sri-automation/strip-cutter/Cutter_v6_templates_1to1_A4.pdf

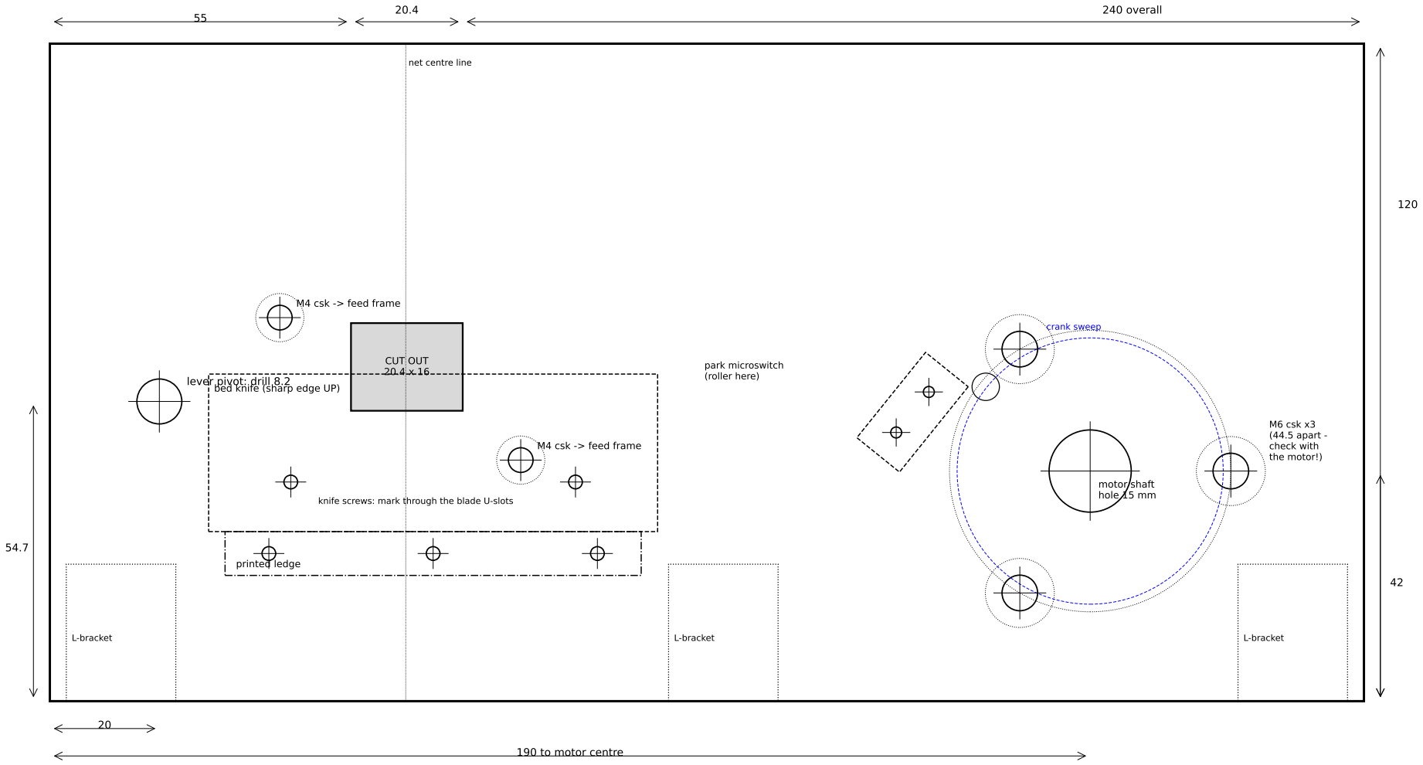
[picture p2: figure]
CUT; OUT; lever pivot: drill 8.2; M4 csk -> feed frame; bed knife (sharp edge UP); printed; ledge; L-bracket; net centre line; motor shaft hole 15 mm; M6 csk x3 (44.5 apart - check with the motor!); crank sweep; park microswitch (roller here); 190 to motor centre; 240 overall

knife screws: mark through the blade U-slots

MAIN PLATE (8 mm plywood, 240 x 120) - FRONT face (knife side). Stepper / motor side on the RIGHT.

<- must measure exactly 100 mm (print at 100 %, "actual size")

Tape on the plywood, cut the outline and the window, drill. Pivot 8.2 mm (M8). Motor shaft 15 mm (spade bit). M4 frame screws: 4.5 mm + countersink this face. MOTOR HOLES: drill the 15 mm shaft hole first. Put the motor behind the plate, shaft through the hole, body pointing UP and to the right (away from the stepper). Dab paint/marker on the 3 boss tops, press the motor on, the dots show the true hole centres. Drill 6.5 mm, countersink this face for M6 x 20 flat heads.
Knife / ledge / switch holes: drill 2.5 mm pilots when you fit those parts (mark through the real parts).

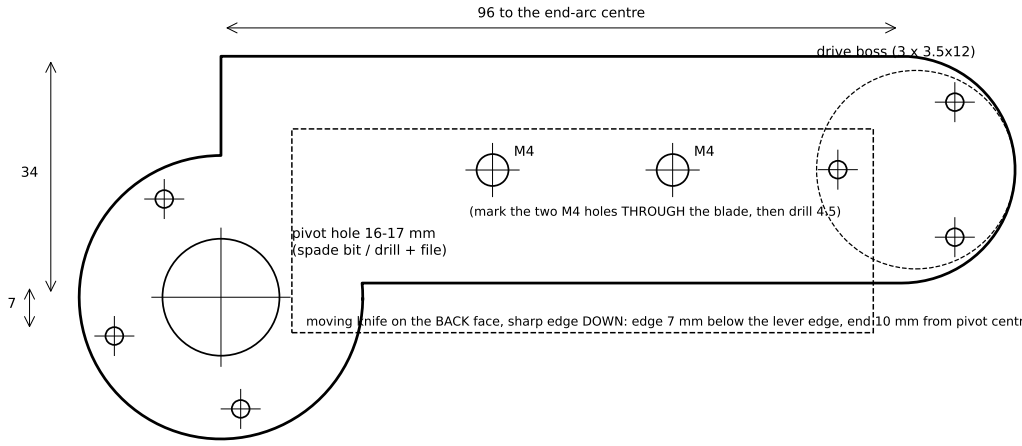
[picture p3: figure]
pivot hole 16-17 mm (spade bit / drill + file); drive boss (3 x 3.5x12); 96 to the end-arc centre

pilots 2.5 for the hub screws (3.5 x 12) moving knife on the BACK face, sharp edge DOWN: edge 7 mm below the lever edge, end 10 mm from pivot centre

(mark the two M4 holes THROUGH the blade, then drill 4.5)

LEVER (8 mm plywood) - FRONT face (hub side). Pivot on the LEFT.

Cut the outline (jigsaw / coping saw), bore the 16-17 mm pivot hole, drill the 2.5 mm pilots.
Drive-boss pilots: max 6 mm deep - the moving knife sits behind one of them.
The knife goes on the BACK face (the face toward the main plate), bevel against the plywood, flat face outward.
Clamp the blade 7.0 mm below and parallel to the lever's straight bottom edge, its end 10 mm right of the pivot centre, mark the 2 threaded holes through the blade, drill 4.5, fix with M4x12 + 2 washers from the front (tip must NOT stick out of the blade's flat face - add a washer if it does).
Drive pin: M8 x 45 hex bolt, head in the printed drive boss (hex pocket against the lever), thread pointing out.

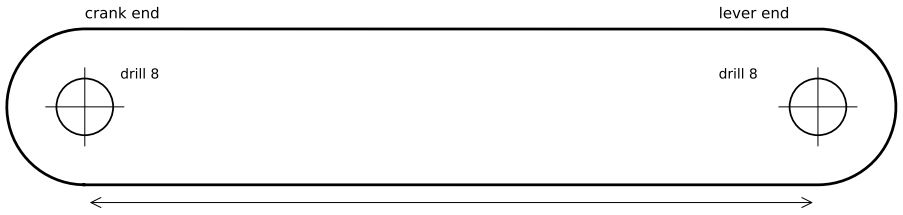
[picture p4: figure]
drill 8; crank end; lever end

103.4 hole centre to hole centre

# LINK (8 mm plywood) - 1:1

Drill the two 8 mm holes square to the face (drill press or a guide block). Check the centre distance: 103-104 mm is fine. Round the ends, sand the edges. A smear of grease in both holes.

STACK ON EACH M8 PIN (lever pin and crank pin are the same):
printed boss | M8 washer | LINK | M8 washer | M8 nylock (snug, then back 1/6 turn so the link turns freely)

The link must clear the M4 screw + washer on the end of the motor shaft by 1-2 mm.
If it rubs: add one more M8 washer under the link on BOTH pins (keeps the link square).
If there is a big gap (> 4 mm) that's fine - nothing to change.

CRANK ON THE MOTOR SHAFT:
1. Push the M8 x 45 crank-pin bolt through the crank from the flat (back) side; its head sits in the hex pocket.
2. Slide the M4 nut sideways into the slot next to the small radial hole; screw in the M4 x 10 grub screw a few turns.
3. Slide the crank on the shaft, flat side toward the plate, until its hub face is flush with the shaft end.
4. Turn the crank until the grub screw drops into the slot on the shaft; tighten it. Check there is ~1.5 mm gap to the plate.
5. M4 x 6 screw + 12 mm washer into the shaft end (keeps the crank from walking off). Only snug; the thread is 5 mm deep.

# BASE BOARD LAYOUT (8 mm plywood 285 x 275) - seen from ABOVE, scale 1:2 (NOT full size)

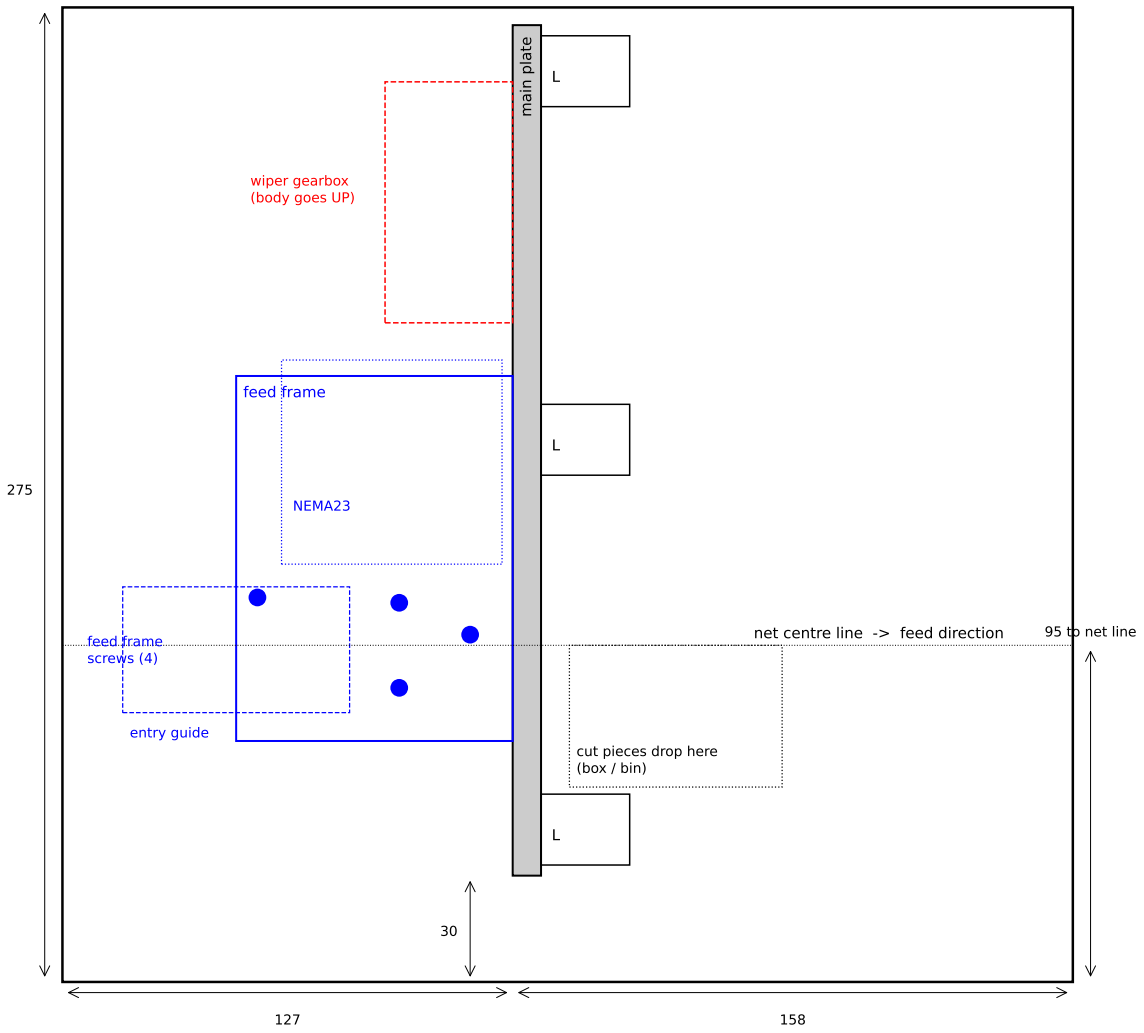
[picture p5: figure]
main plate; feed; frame; entry guide; NEMA23; wiper gearbox (body goes UP); screws (4); net centre line -> feed direction; cut pieces drop here (box / bin); 95 to net line

<- 100 mm bar is for printer check only; this page is NOT full size

Coordinates: the main plate's BACK face is 127 mm from the entry-side edge of the board; its left end is 30 mm from the board edge.
1. Stand the main plate on the board, back face on the line. 3 L-brackets on the FRONT (knife) side: wood screws into plate and board.
2. Push the feed frame against the plate's back face, net channel lined up with the window. 2 x M4 x 20 flat heads from the front
of the plate into the frame (holes on the template), then 4 wood screws (4 x 10-12 mm) through the frame's counterbored holes.
3. The motor bolts only to the plate - keep the gearbox >= 5 mm away from the stepper.
4. Cut pieces fall in front of the knife: put a small box there.
