sri-automation/strip-cutter/electronics_v5_app_phone.png

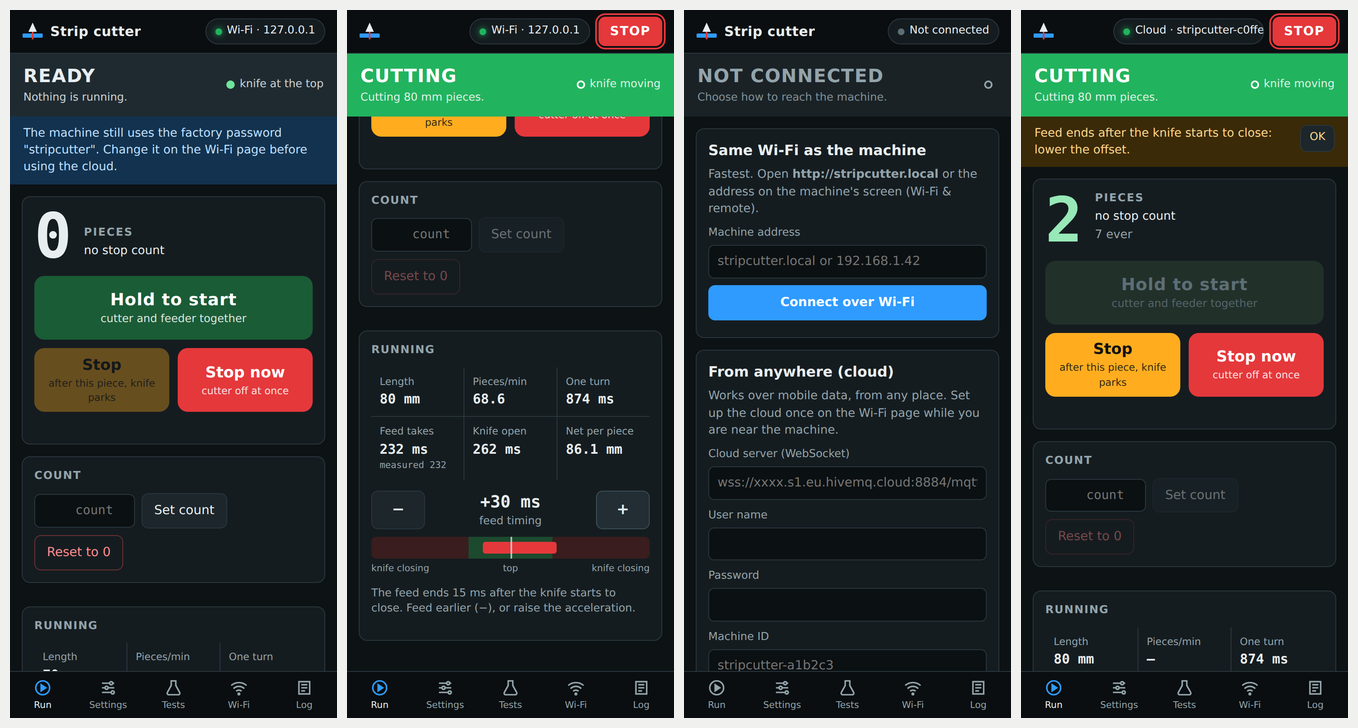
electronics_v5_app_phone.png
