sri-automation/strip-cutter/electronics_v5_screen_1.png

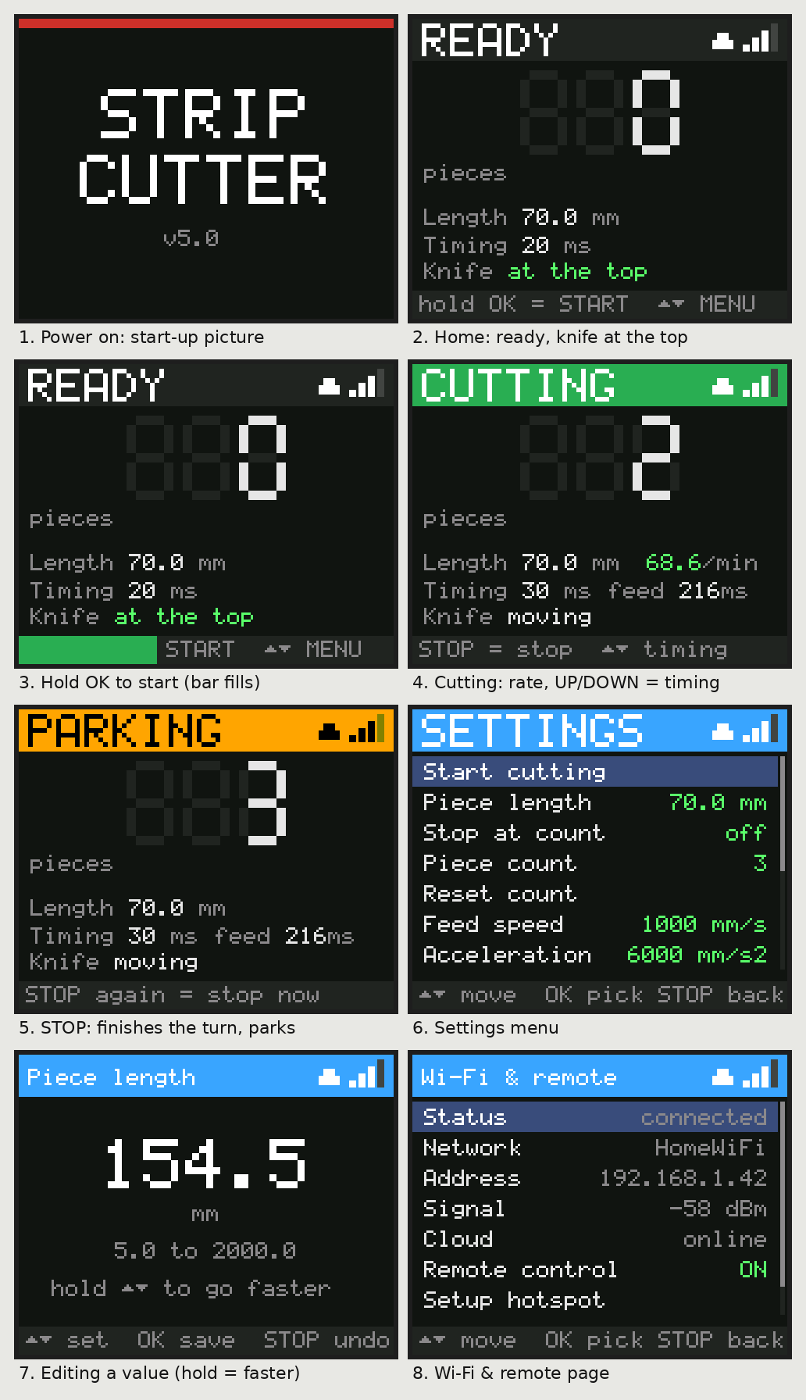
electronics_v5_screen_1.png
