sri-automation/strip-cutter/electronics_v5_screen_2.png

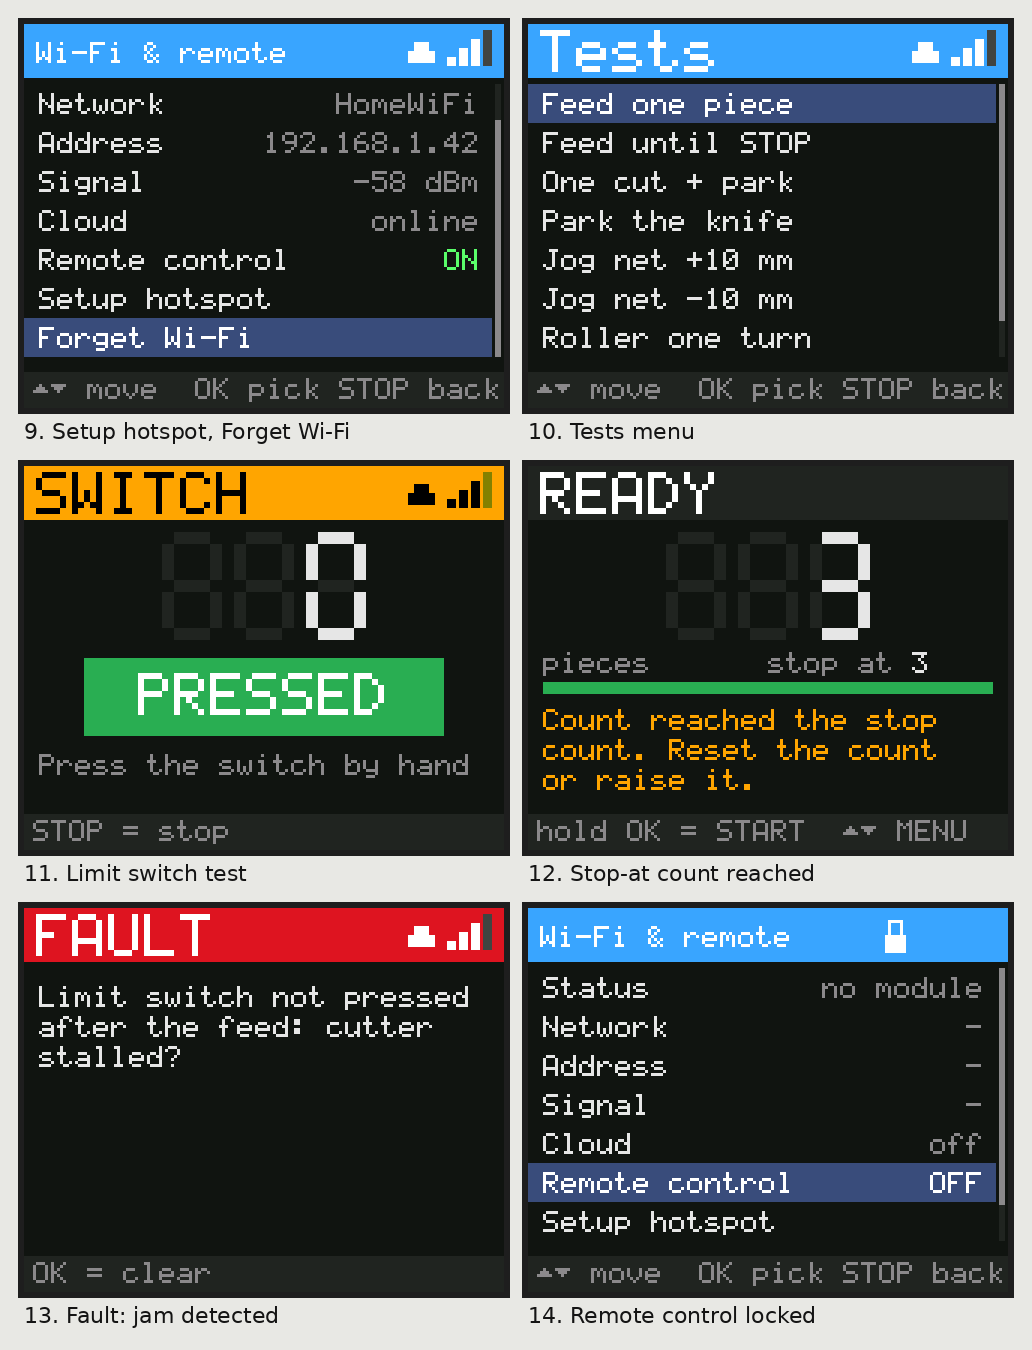
electronics_v5_screen_2.png
