sri-automation/strip-cutter/v4_view_entry_side.png

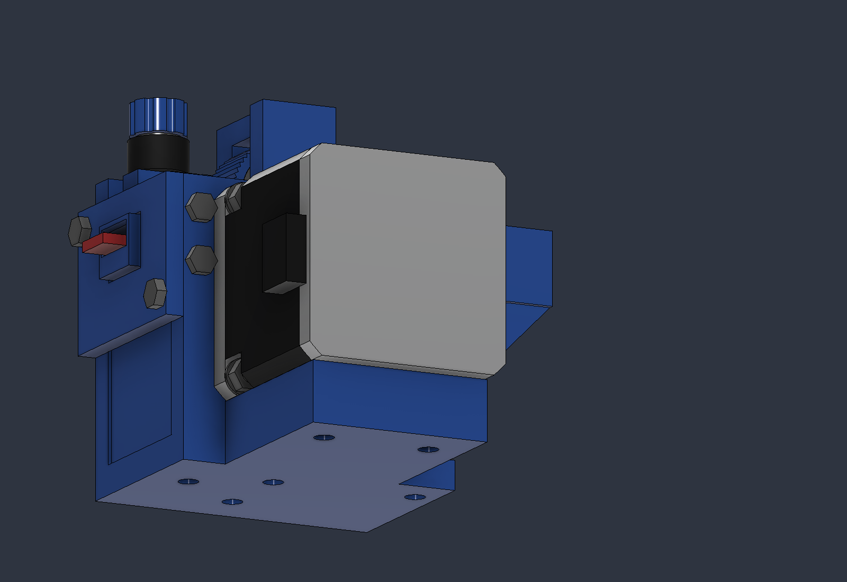
v4_view_entry_side.png
