sri-automation/strip-cutter/v5_nip_cheeks_explained.png

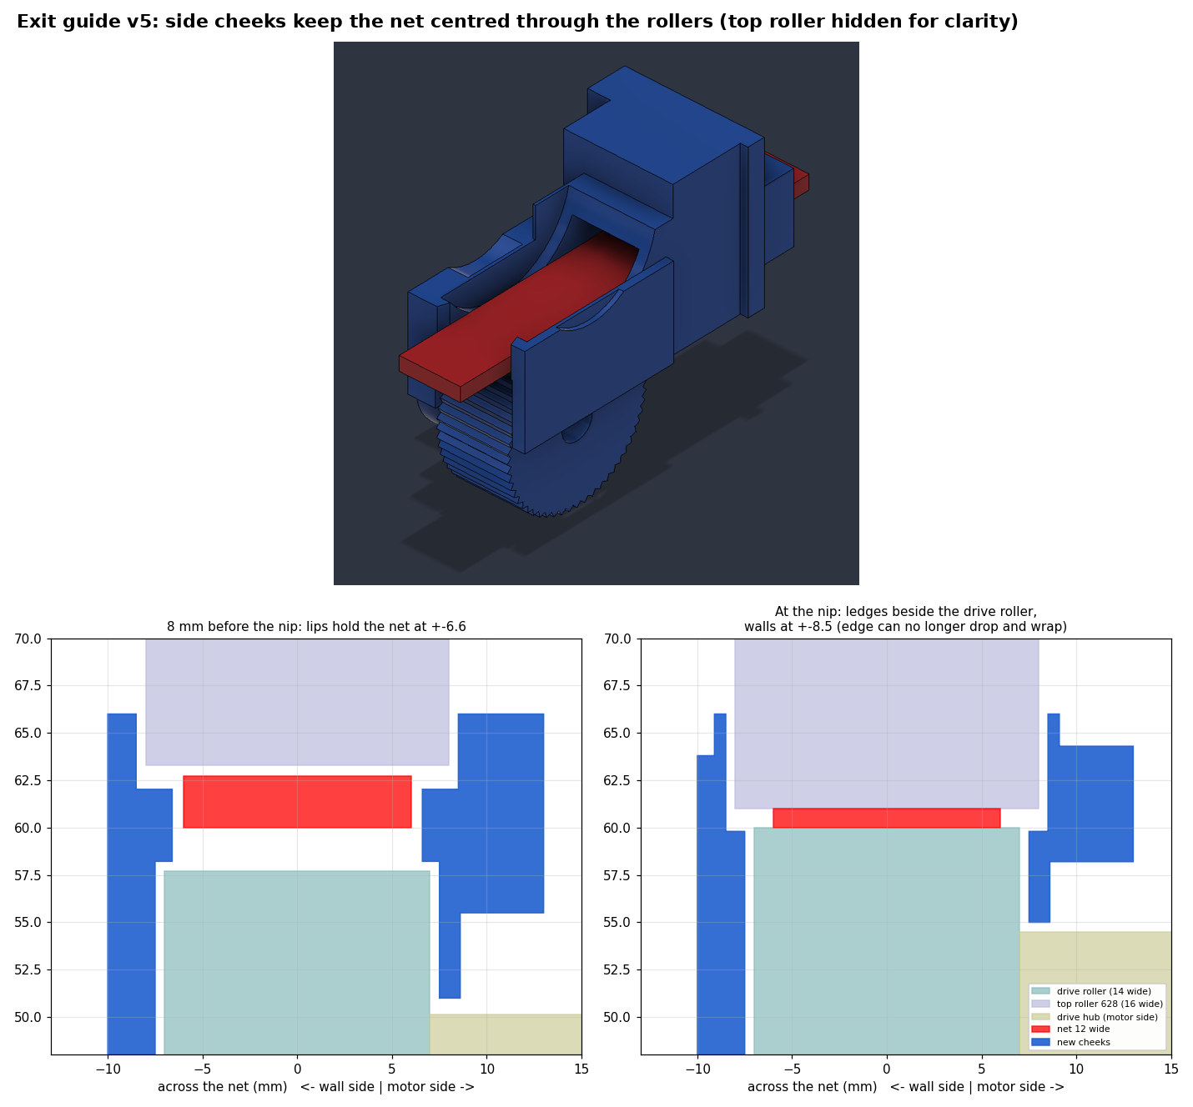
v5_nip_cheeks_explained.png
