sri-automation/strip-cutter/v5_nip_cheeks_top.png

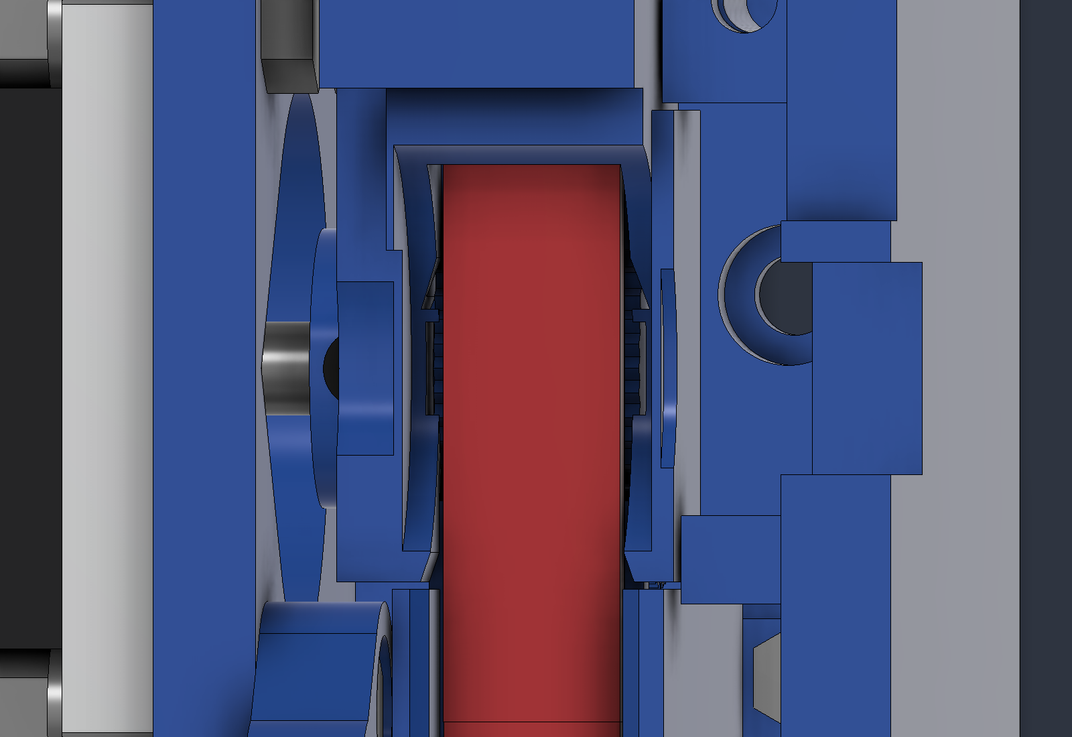
v5_nip_cheeks_top.png
