sri-automation/strip-cutter/v5_nip_cheeks_view.png

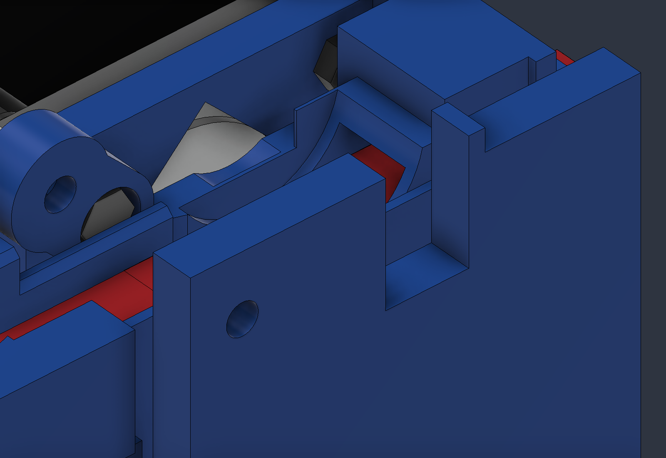
v5_nip_cheeks_view.png
