sri-automation/strip-cutter/v6_cutter_drive_back.png

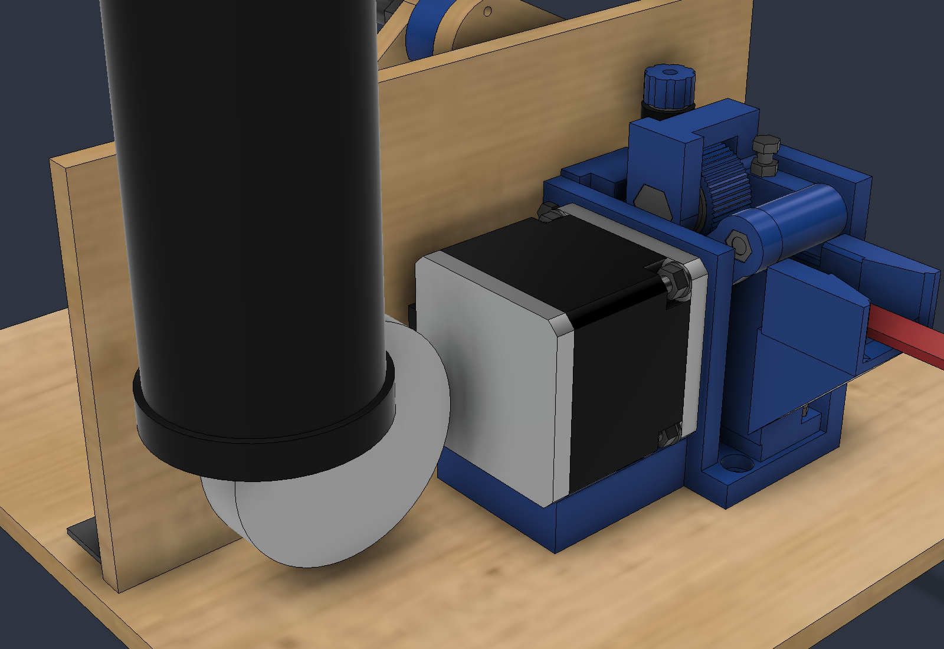
v6_cutter_drive_back.png
