sri-automation/strip-cutter/v6_cutter_drive_front.png

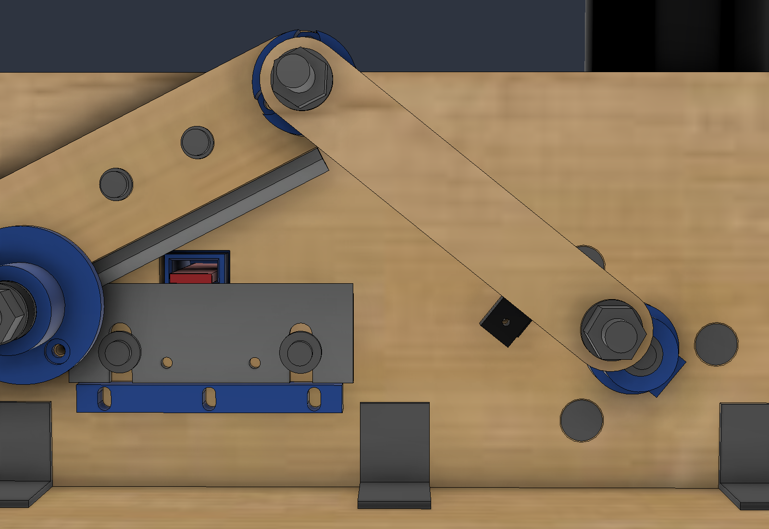
v6_cutter_drive_front.png
