sri-automation/strip-cutter/v6_cutter_drive_iso.png

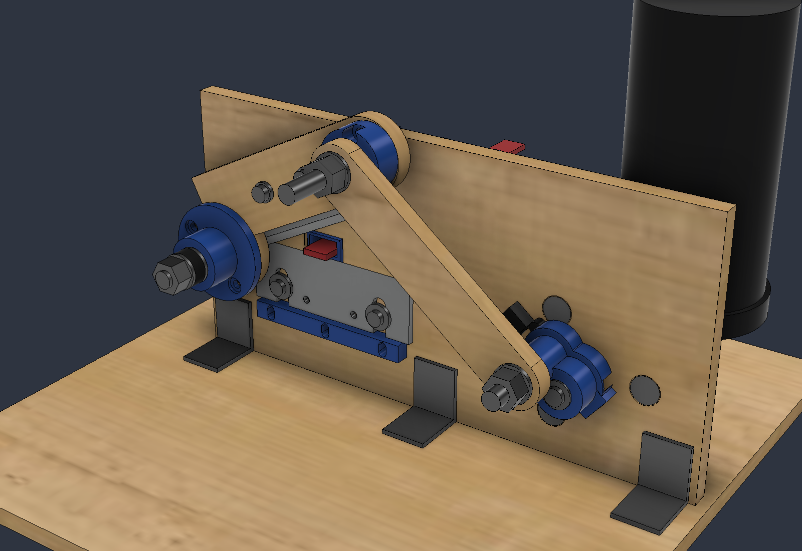
v6_cutter_drive_iso.png
