sri-automation/strip-cutter/v7_pinch_yoke.png

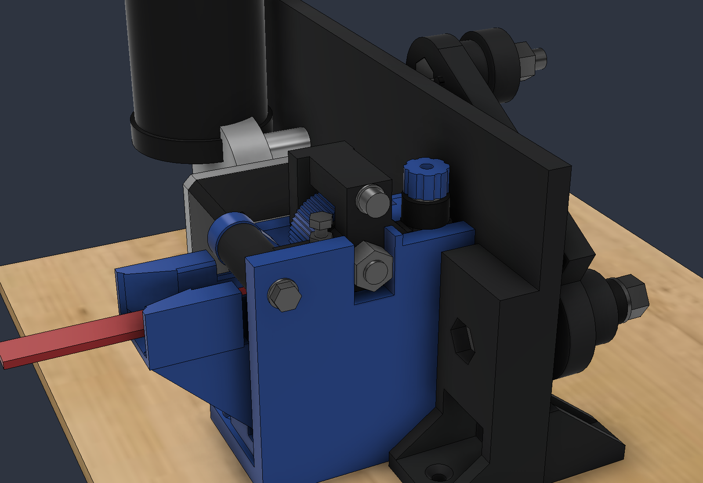
v7_pinch_yoke.png
