sri-automation/strip-cutter/v9_ramp_front.png

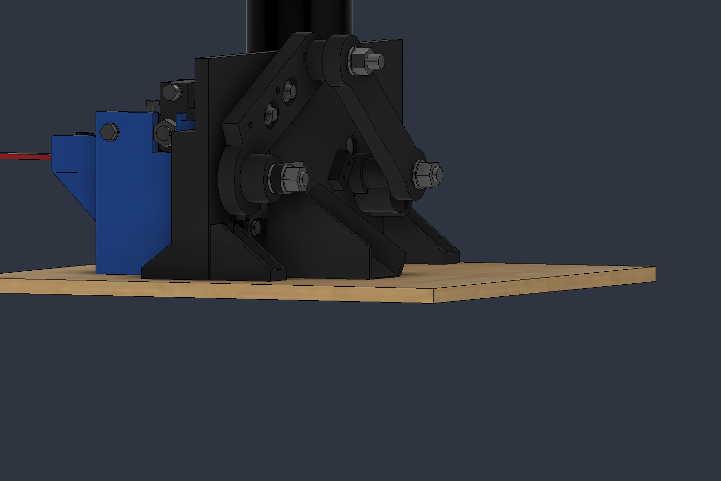
v9_ramp_front.png
