sri-automation/strip-cutter/v9_ramp_side.png

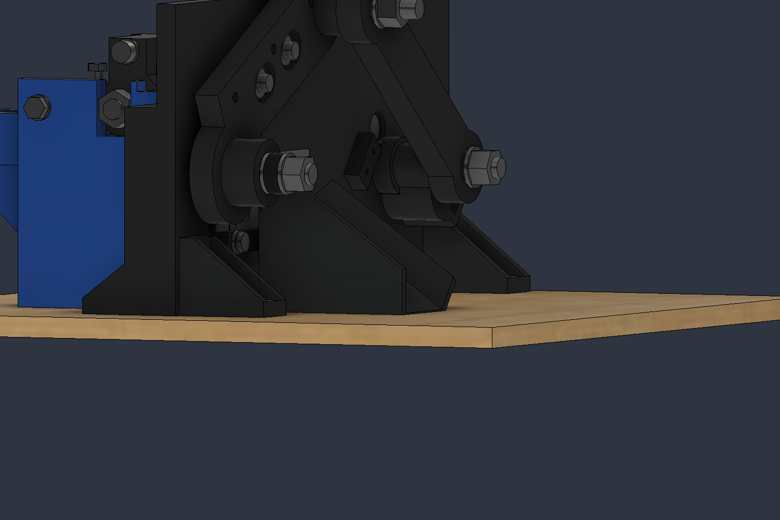
v9_ramp_side.png
