sri-automation/strip-cutter/v10_filler_v2_front_view.png

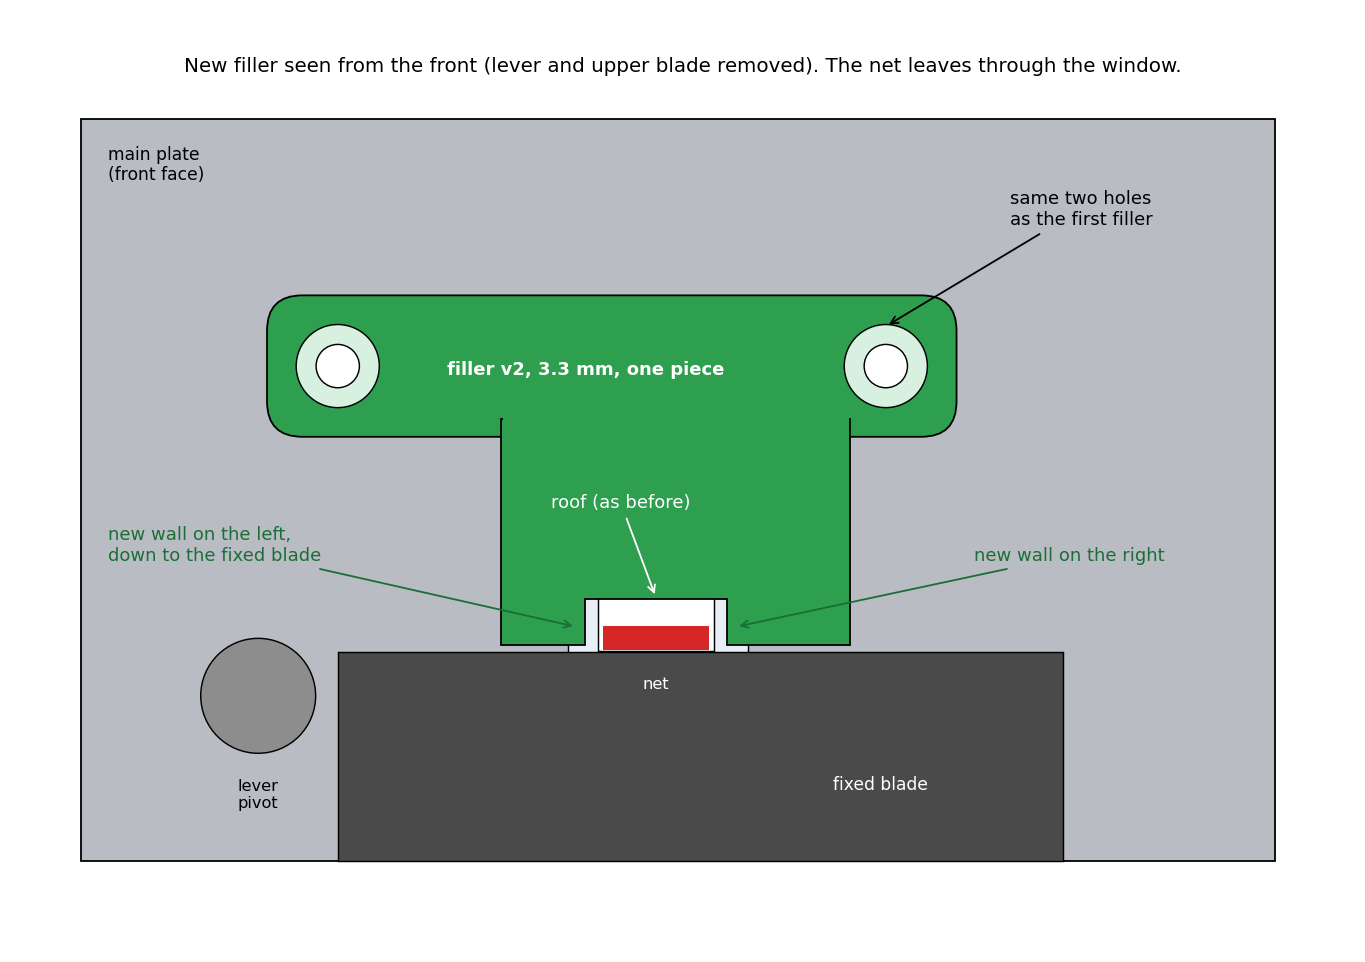
v10_filler_v2_front_view.png
