sri-automation/strip-cutter/v10_gap_filler_where_to_drill.png

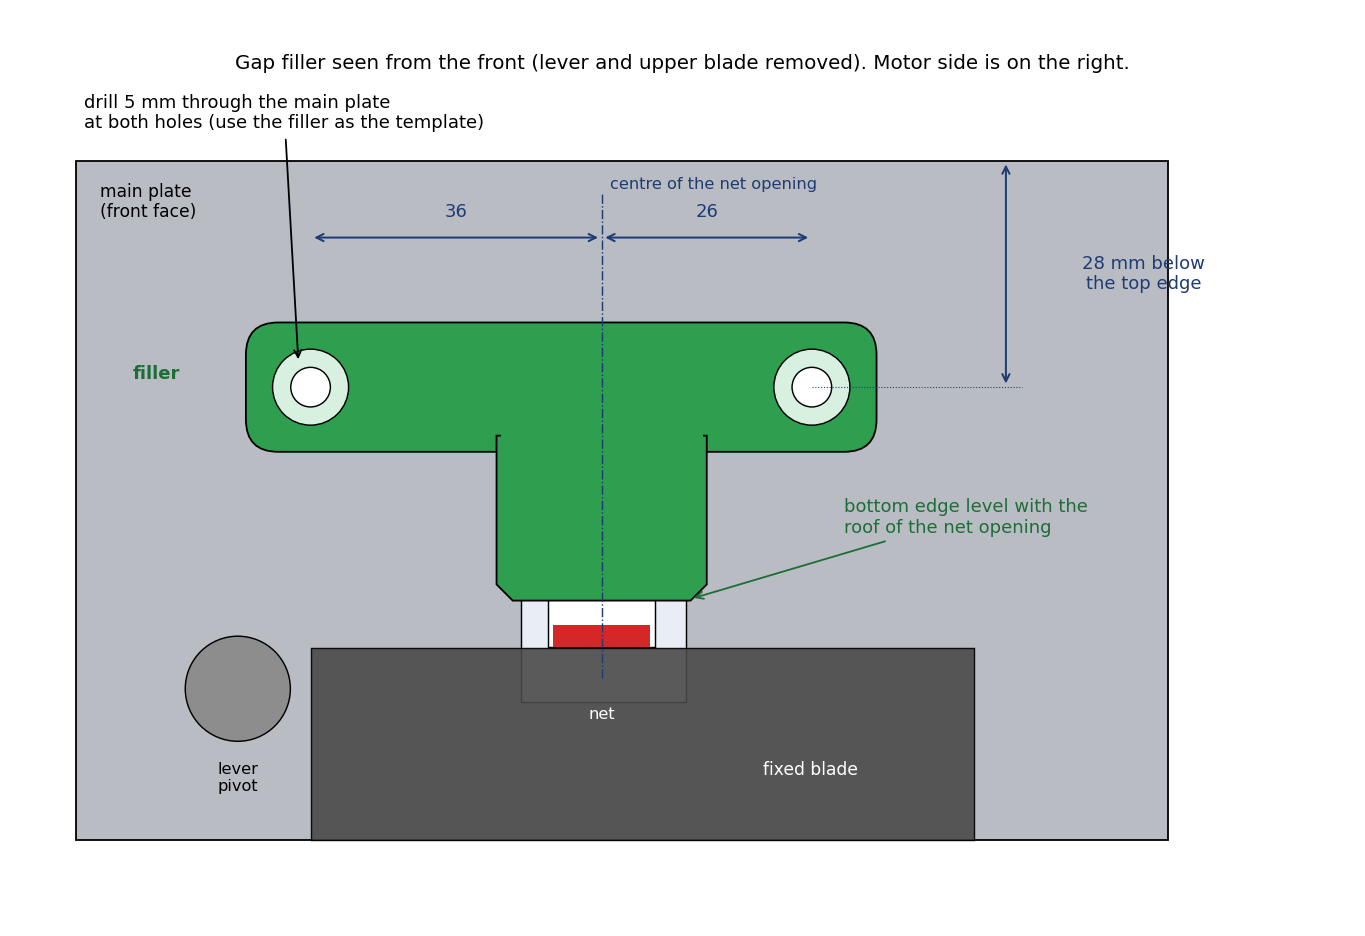
v10_gap_filler_where_to_drill.png
