sri-automation/strip-cutter/v11_exit_nozzle_side_view.png

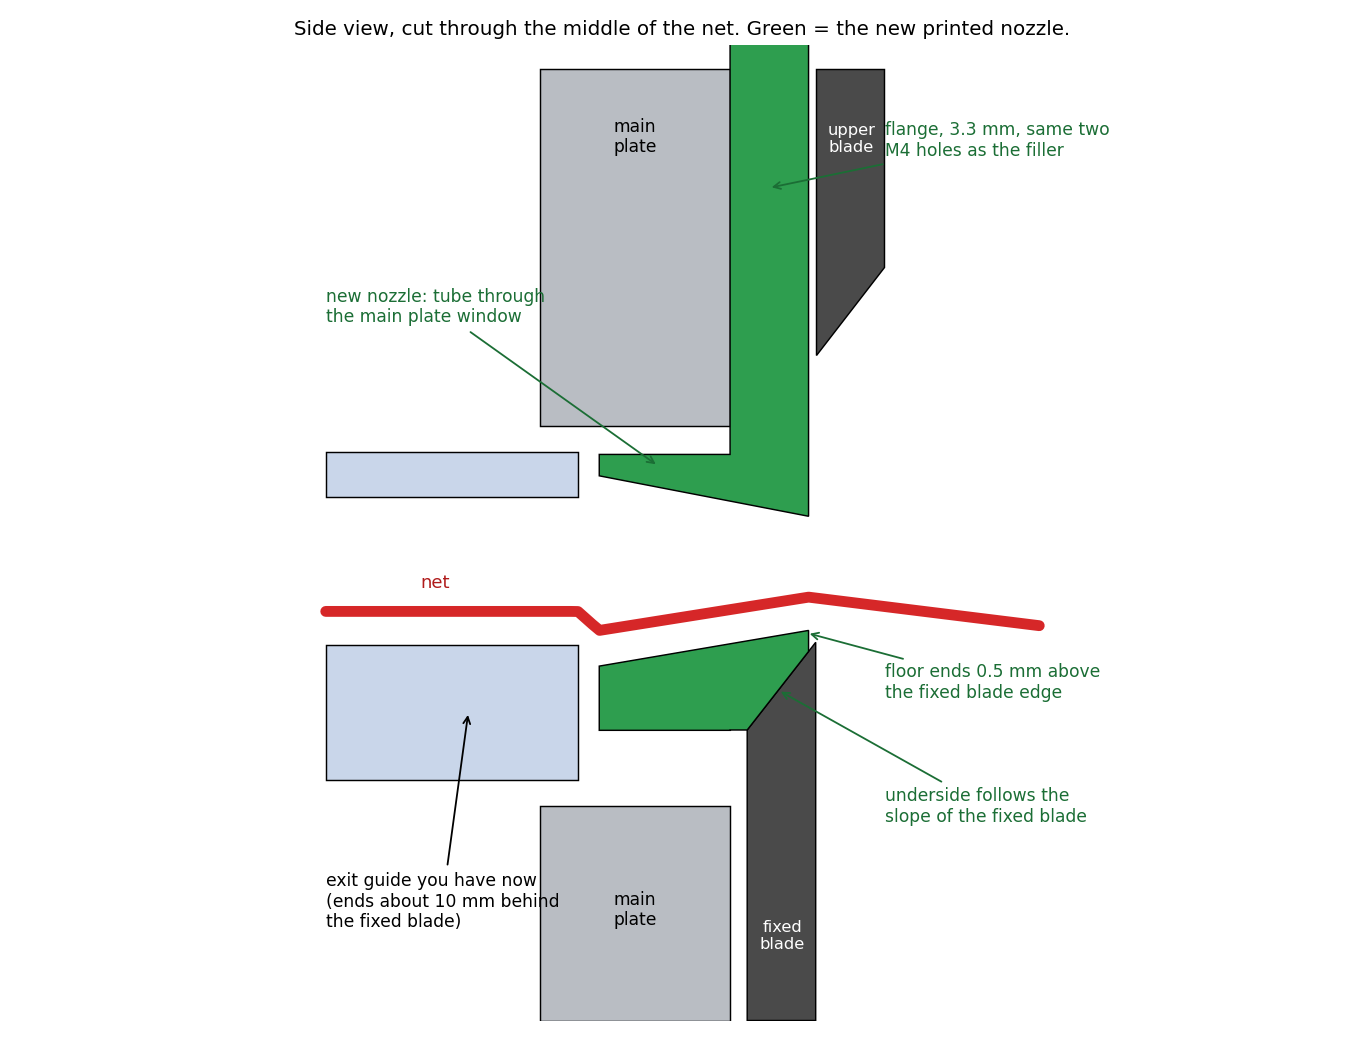
v11_exit_nozzle_side_view.png
