sri-automation/strip-cutter/print_STL_feeder_v7/v7_Exit_Guide_assembly_position.stl

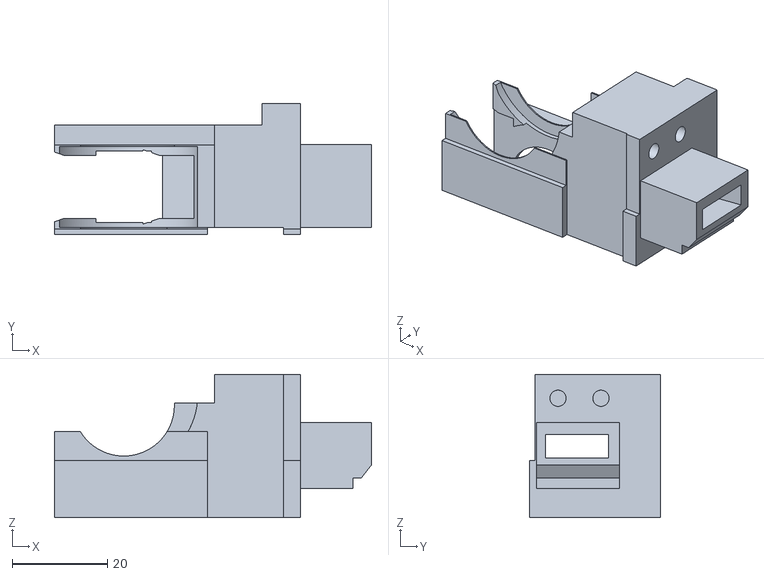
[picture p22: CAD file, 2026-10-26]
print_STL_feeder_v7/v7_Exit_Guide_assembly_position.stl
66.4 x 27.5 x 30.0
