sri-automation/strip-cutter/print_STL_feeder_v7/v7_Pinch_Arm_assembly_position.stl

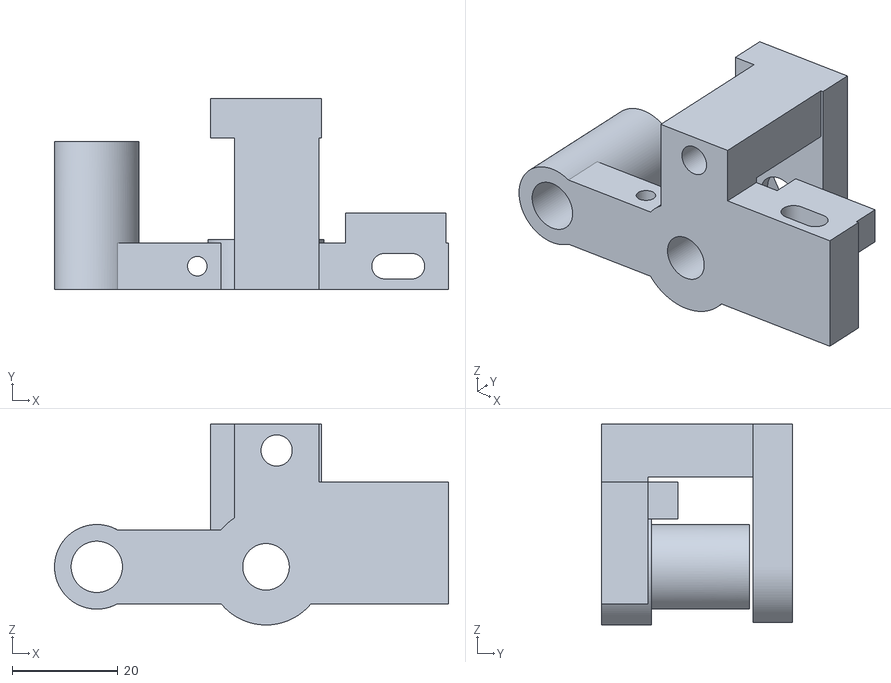
[picture p23: CAD file, 2026-10-26]
print_STL_feeder_v7/v7_Pinch_Arm_assembly_position.stl
74.5 x 36.1 x 38.0
