sri-automation/strip-cutter/print_STL_hmi_enclosure_v1/HMI_enclosure_v1_assembly.step

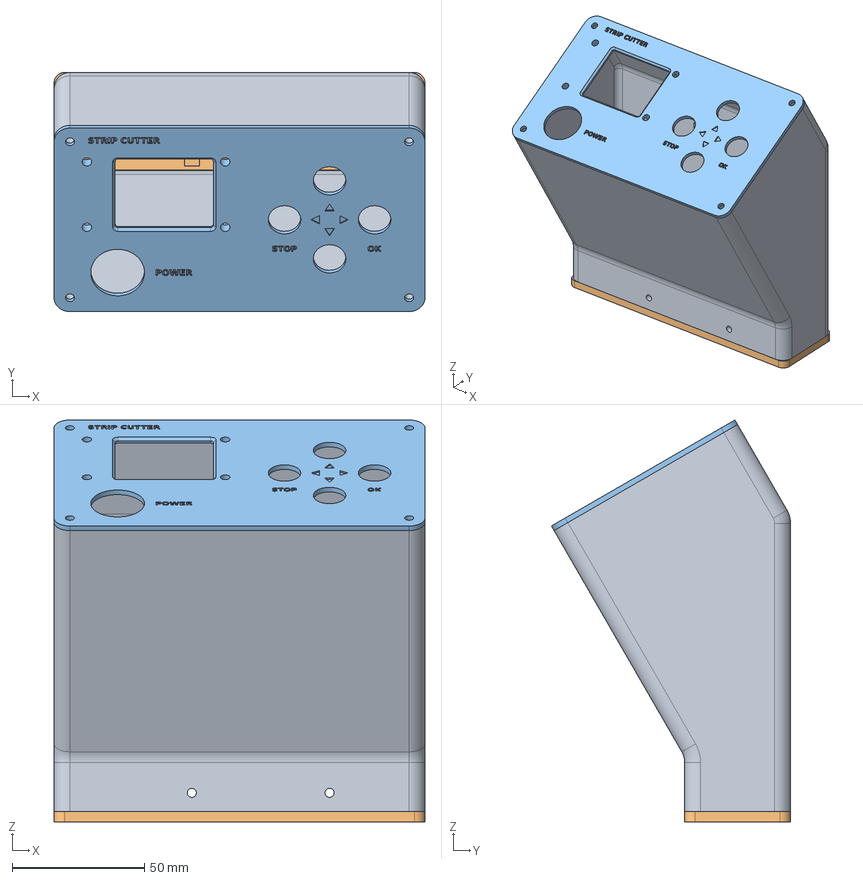
[picture p24: CAD file, 2026-10-27]
print_STL_hmi_enclosure_v1/HMI_enclosure_v1_assembly.step
140.0 x 90.3 x 151.7 mm
Tower
Foot
Front plate v2
