sri-automation/strip-cutter/print_STL_cutter_v11/Strip_Cutter_v11_exit_nozzle_PETG-CF_0.6_nozzle.3mf

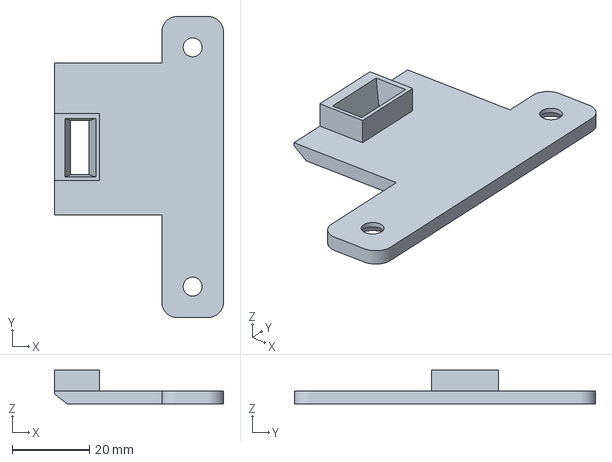
[picture p25: CAD file, 2026-10-26]
print_STL_cutter_v11/Strip_Cutter_v11_exit_nozzle_PETG-CF_0.6_nozzle.3mf
43.8 x 78.0 x 8.80 mm
