sri-automation/strip-cutter/print_STL_feeder/Drive_Roller_6.00mm_shaft.stl

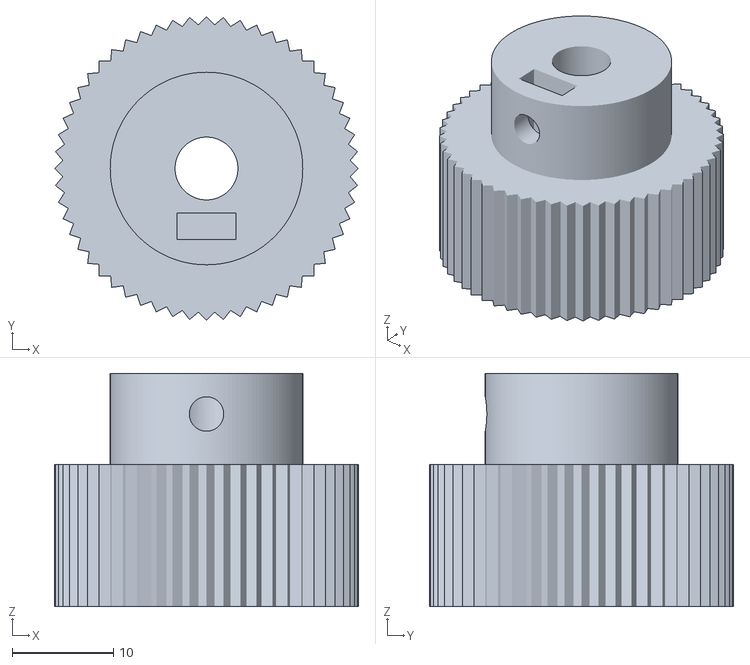
[picture p26: CAD file, 2026-10-26]
print_STL_feeder/Drive_Roller_6.00mm_shaft.stl
30.0 x 30.0 x 23.0
