sri-automation/strip-cutter/print_STL_feeder_v7/Feeder_v7_arm_and_exit_guide_PETG-CF_0.6_nozzle.3mf

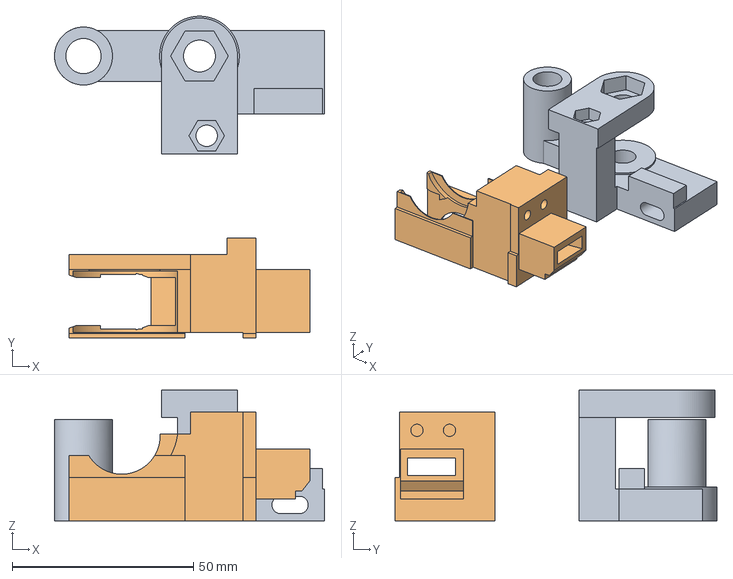
[picture p27: CAD file, 2026-10-26]
print_STL_feeder_v7/Feeder_v7_arm_and_exit_guide_PETG-CF_0.6_nozzle.3mf
74.5 x 88.7 x 36.1 mm
v7_Pinch_Arm_strong.stl
v7_Exit_Guide.stl
