sri-automation/strip-cutter/print_STL_hmi_enclosure_v1/HMI_enclosure_v1_A1.3mf

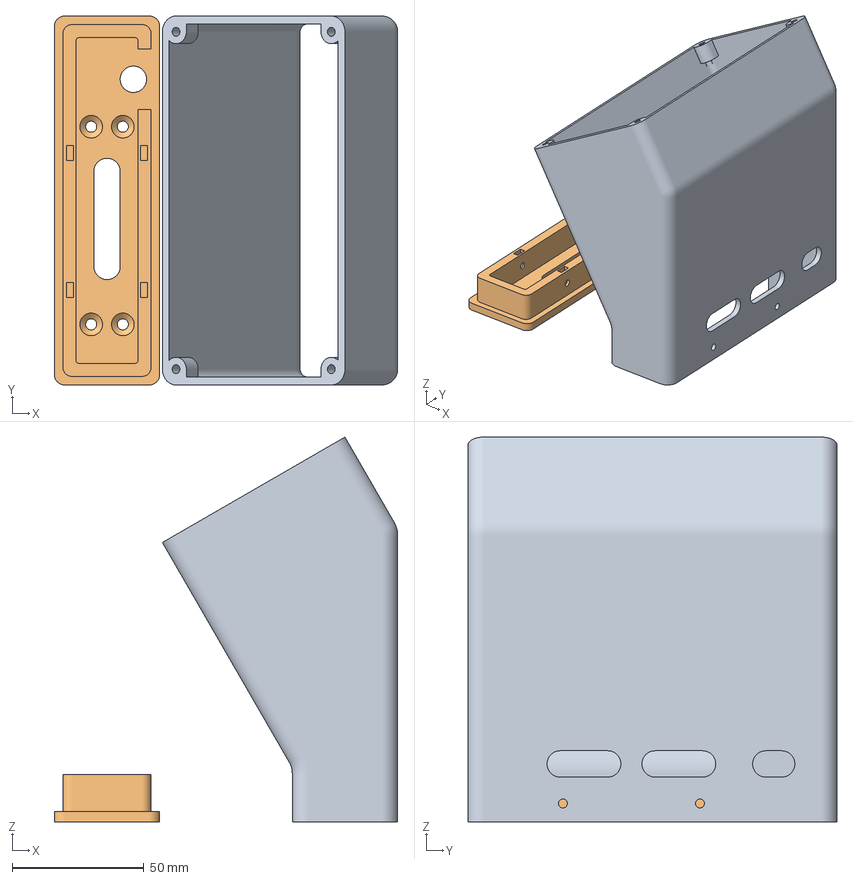
[picture p28: CAD file, 2026-10-27]
print_STL_hmi_enclosure_v1/HMI_enclosure_v1_A1.3mf
130.3 x 140.0 x 146.0 mm
HMI_enclosure_tower.stl
HMI_enclosure_foot.stl
