sri-automation/strip-cutter/print_STL_hmi_panel_v2/HMI_panel_v2_A1.3mf

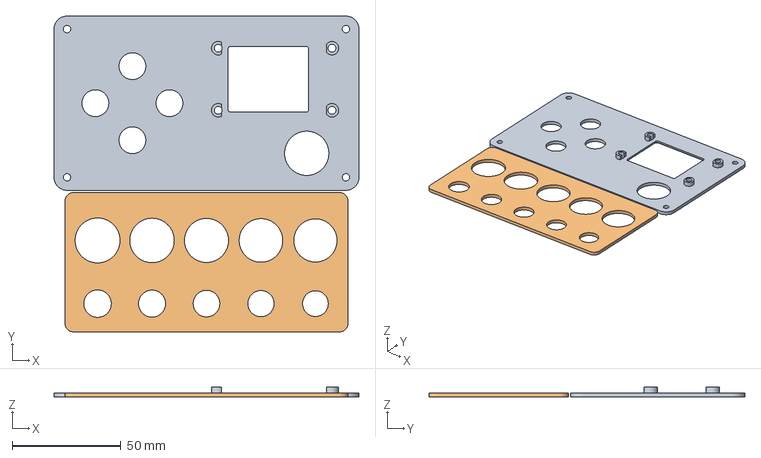
[picture p29: CAD file, 2026-10-26]
print_STL_hmi_panel_v2/HMI_panel_v2_A1.3mf
140.0 x 145.0 x 4.75 mm
HMI_front_plate_v2.stl
HMI_hole_gauge.stl
