sri-automation/strip-cutter/print_STL_feeder/Top_Roller_Spacer_x2.stl

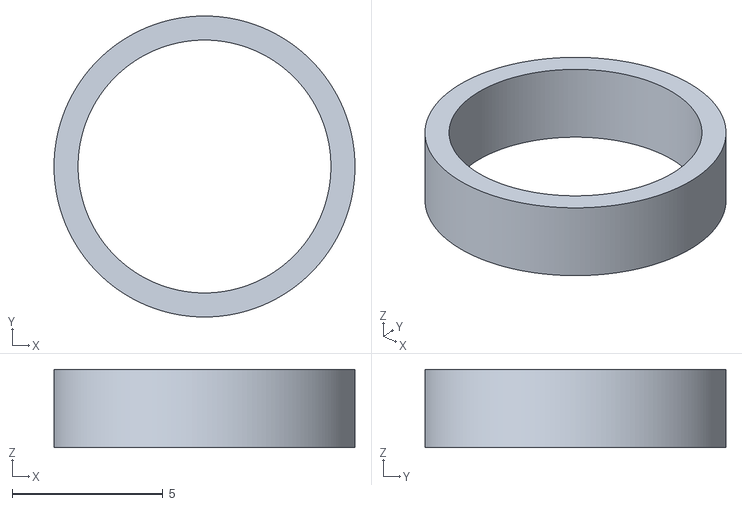
[picture p30: CAD file, 2026-10-26]
print_STL_feeder/Top_Roller_Spacer_x2.stl
10.0 x 10.00 x 2.60
