sri-automation/strip-cutter/print_STL_feeder/Feed_Frame.stl

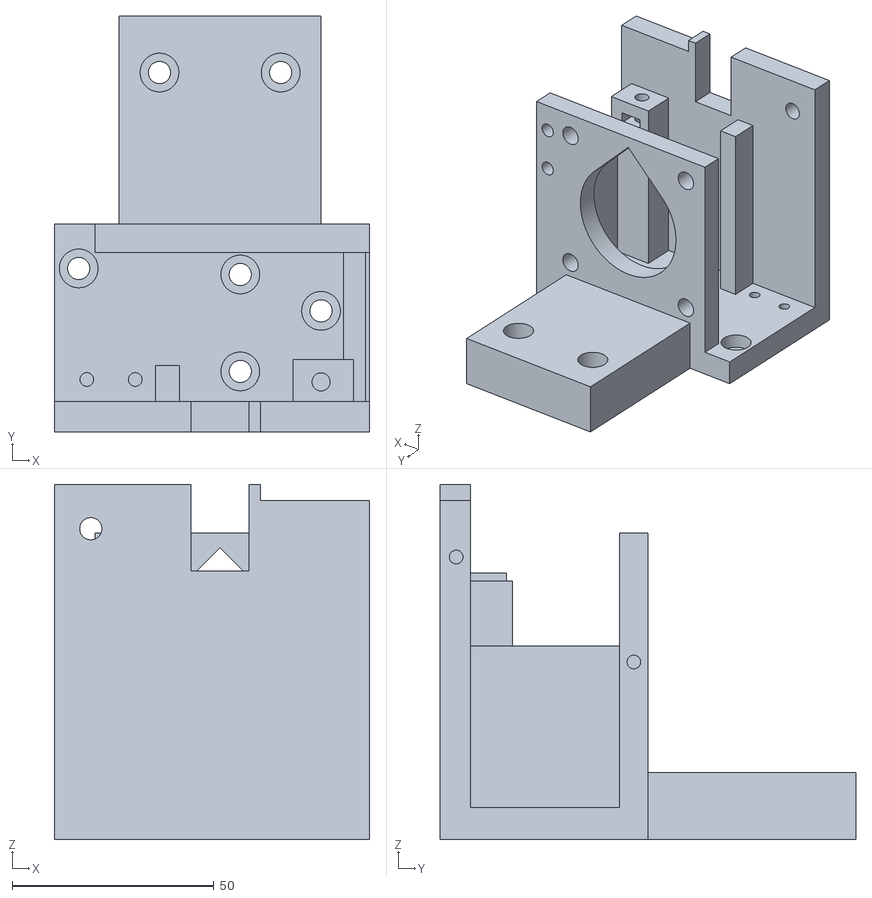
[picture p31: CAD file, 2026-10-26]
print_STL_feeder/Feed_Frame.stl
78.0 x 103.0 x 88.0
