sri-automation/strip-cutter/print_STL_hmi_enclosure_v1/HMI_enclosure_foot.step

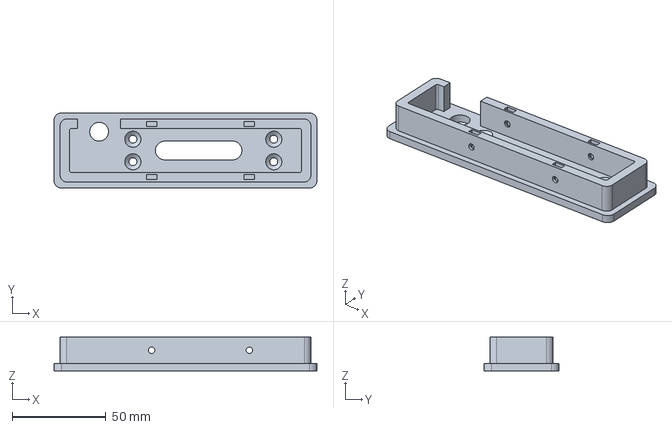
[picture p32: CAD file, 2026-10-27]
print_STL_hmi_enclosure_v1/HMI_enclosure_foot.step
140.0 x 40.0 x 18.0 mm
