sri-automation/strip-cutter/print_STL_hmi_panel_v2/HMI_hole_gauge.stl

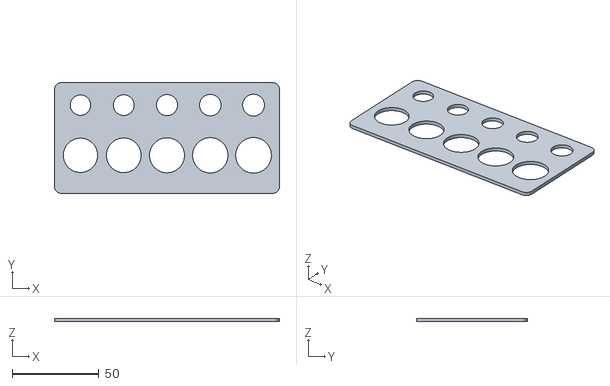
[picture p33: CAD file, 2026-10-26]
print_STL_hmi_panel_v2/HMI_hole_gauge.stl
130.0 x 64.0 x 2.00
