sri-automation/strip-cutter/cad/Strip_Cutter_v8.step

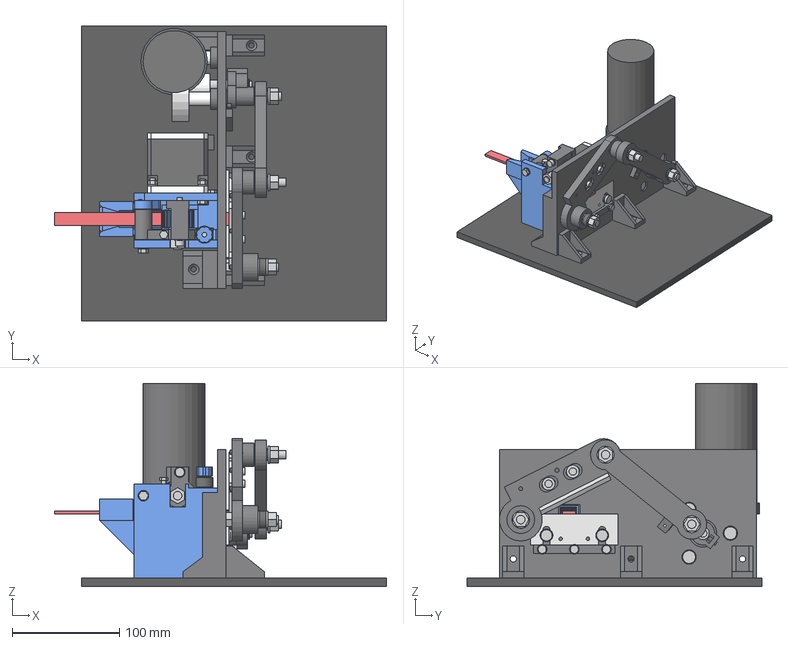
[picture p34: CAD file, 2026-10-26]
cad/Strip_Cutter_v8.step
310.0 x 275.0 x 190.0 mm
