sri-automation/strip-cutter/print_STL_feeder/Pressure_Knob.stl

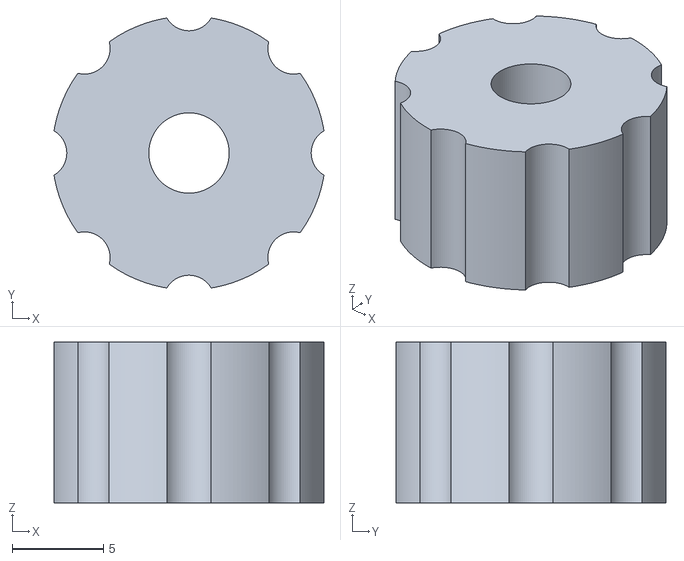
[picture p35: CAD file, 2026-10-26]
print_STL_feeder/Pressure_Knob.stl
14.8 x 14.8 x 8.80
