sri-automation/strip-cutter/print_STL_hmi_enclosure_v1/HMI_enclosure_tower.step

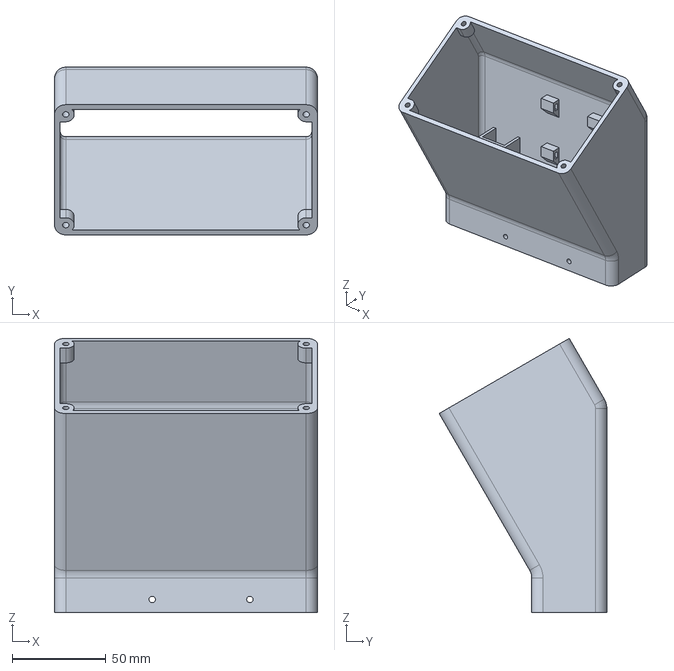
[picture p36: CAD file, 2026-10-27]
print_STL_hmi_enclosure_v1/HMI_enclosure_tower.step
140.0 x 89.3 x 146.0 mm
