sri-automation/strip-cutter/print_STL_hmi_panel_v2/HMI_front_plate_v2.step

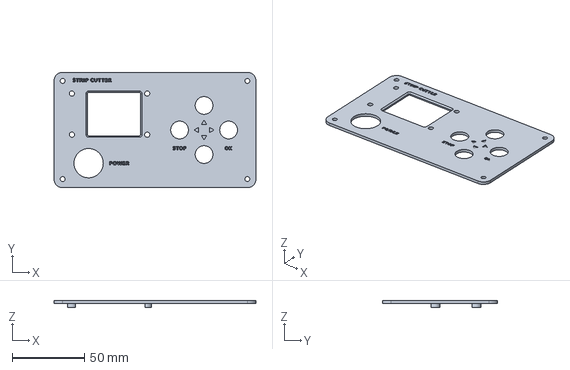
[picture p37: CAD file, 2026-10-26]
print_STL_hmi_panel_v2/HMI_front_plate_v2.step
140.0 x 80.0 x 4.75 mm
