sri-automation/strip-cutter/print_STL_feeder/Entry_Guide.stl

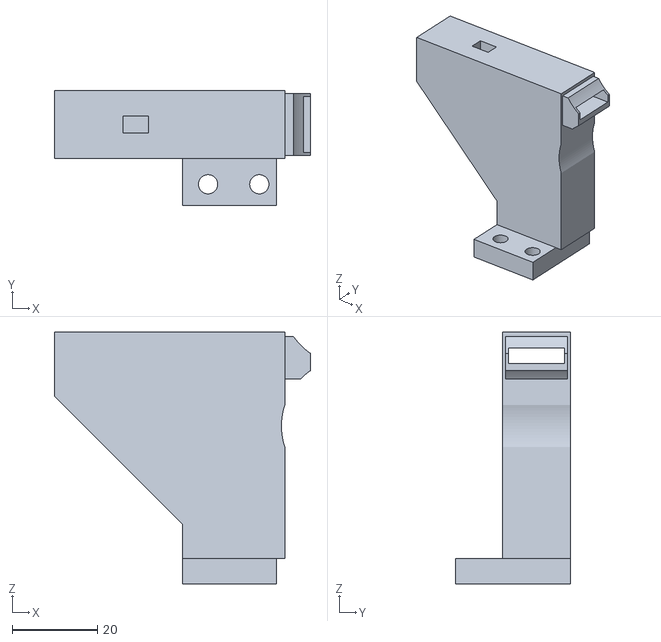
[picture p38: CAD file, 2026-10-26]
print_STL_feeder/Entry_Guide.stl
60.0 x 27.0 x 59.0
