sri-automation/strip-cutter/print_STL_feeder/Pinch_Roller_688.stl

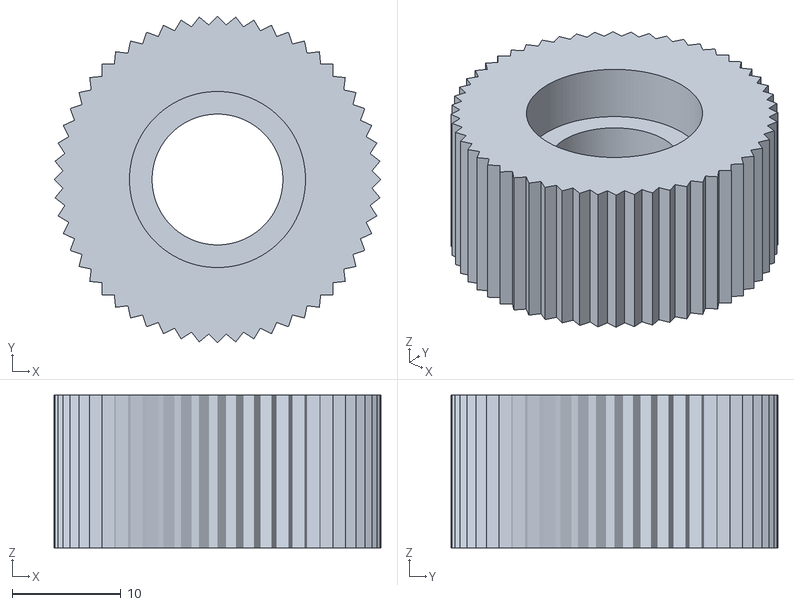
[picture p39: CAD file, 2026-10-26]
print_STL_feeder/Pinch_Roller_688.stl
30.0 x 30.0 x 14.0
