sri-automation/strip-cutter/print_STL_feeder/Pinch_Arm.stl

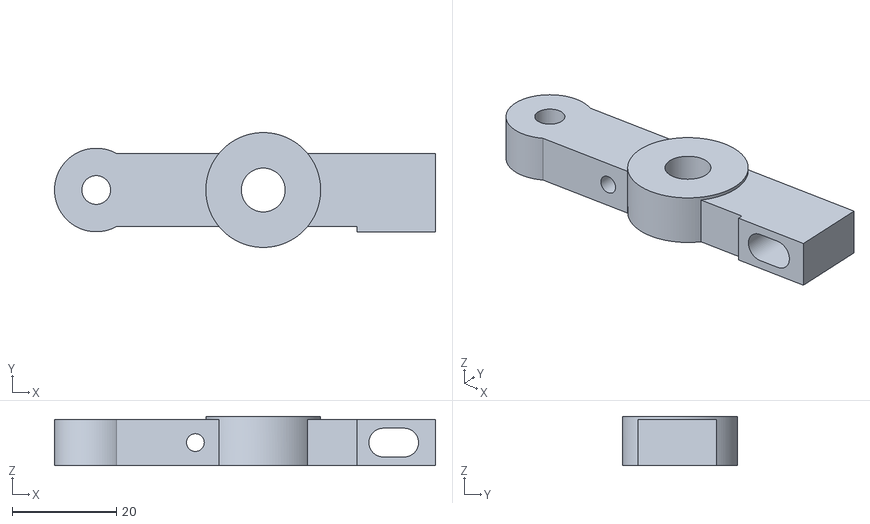
[picture p40: CAD file, 2026-10-26]
print_STL_feeder/Pinch_Arm.stl
73.0 x 22.0 x 9.40
