sri-automation/strip-cutter/print_STL_feeder/Exit_Guide.stl

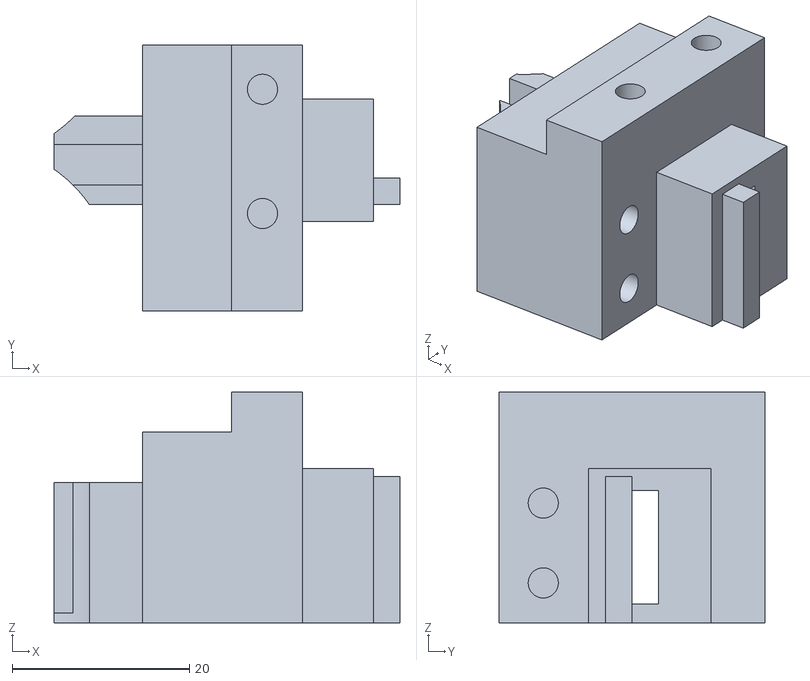
[picture p41: CAD file, 2026-10-26]
print_STL_feeder/Exit_Guide.stl
39.0 x 30.0 x 26.0
