sri-automation/strip-cutter/print_STL_feeder/Pinch_Roller.stl

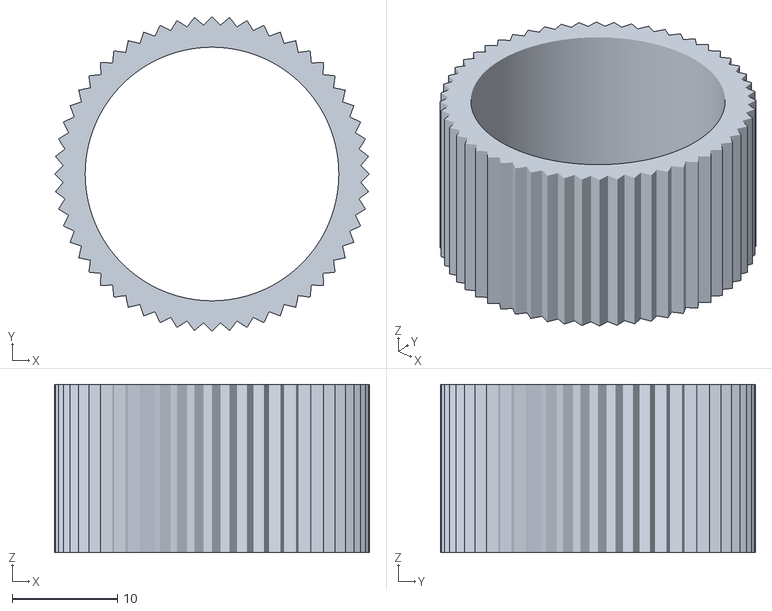
[picture p42: CAD file, 2026-10-26]
print_STL_feeder/Pinch_Roller.stl
30.0 x 30.0 x 16.0
