sri-automation/strip-cutter/(list of files, cad)

Other CAD files:
print_STL_cutter_v11/c11_Exit_Nozzle_3.3mm.stl
print_STL_feeder_v7/v7_Pinch_Arm_strong.stl
print_STL_hmi_enclosure_v1/HMI_enclosure_v1_A1.gcode.3mf
print_STL_hmi_panel_v2/HMI_panel_v2_A1.gcode.3mf
print_STL_feeder_v7/v7_Exit_Guide.stl
print_STL_feeder/Drive_Roller_6.35mm_shaft.stl
cad/Strip_Cutter_v3.f3d
cad/Strip_Cutter_v3.step
cad/Strip_Cutter_v4.f3d
cad/Strip_Cutter_v4.step
cad/Strip_Cutter_v6.step
cad/Strip_Cutter_v8.f3d
print_STL_cutter_v10/Strip_Cutter_v10_filler_shims_PETG-CF_0.6_nozzle.3mf
print_STL_cutter_v10/Strip_Cutter_v10_filler_v2_3.3mm_PETG-CF_0.6_nozzle.3mf
print_STL_cutter_v10/Strip_Cutter_v10_gap_filler_PETG-CF_0.6_nozzle.3mf
print_STL_cutter_v10/c10_Gap_Filler_2.1mm_cut_corner.stl
print_STL_cutter_v10/c10_Gap_Filler_2.4mm.stl
print_STL_cutter_v10/c10_Gap_Filler_v2_3.3mm_side_walls.stl
print_STL_cutter_v10/c10_Shim_0.6mm_1_notch.stl
print_STL_cutter_v10/c10_Shim_0.9mm_2_notches.stl
print_STL_cutter_v10/c10_Shim_1.2mm_3_notches.stl
print_STL_cutter_v6/c6_Bed_Knife_Ledge.stl
print_STL_cutter_v6/c6_Crank.stl
print_STL_cutter_v6/c6_Knife_Height_Gauge.stl
print_STL_cutter_v6/c6_Lever_Drive_Boss.stl
print_STL_cutter_v6/c6_Lever_Pivot_Hub.stl
print_STL_cutter_v7/Strip_Cutter_v7_PETG-CF_0.6_nozzle.3mf
print_STL_cutter_v7/c7_Bed_Knife_Ledge.stl
print_STL_cutter_v7/c7_Crank.stl
print_STL_cutter_v7/c7_Fit_Test.3mf
print_STL_cutter_v7/c7_Fit_Test.stl
print_STL_cutter_v7/c7_Knife_Height_Gauge.stl
print_STL_cutter_v7/c7_Knife_Lever.stl
print_STL_cutter_v7/c7_Link.stl
print_STL_cutter_v7/c7_Motor_Test_Template.stl
print_STL_cutter_v7/c7_Pin_Spacer.stl
print_STL_cutter_v7/c7_Pinch_Yoke_CF.stl
print_STL_cutter_v7/later_after_template_test/c7_Front_Bracket_DRAFT.stl
print_STL_cutter_v7/later_after_template_test/c7_Main_Plate_DRAFT.stl
print_STL_cutter_v8/Strip_Cutter_v8_PETG-CF_0.6_nozzle.3mf
print_STL_cutter_v8/c8_Bed_Knife_Ledge.stl
print_STL_cutter_v8/c8_Crank.stl
print_STL_cutter_v8/c8_Fit_Gauge.stl
print_STL_cutter_v8/c8_Front_Bracket.stl
print_STL_cutter_v8/c8_Knife_Lever.stl
print_STL_cutter_v8/c8_Link.stl
print_STL_cutter_v8/c8_Main_Plate.stl
print_STL_cutter_v8/c8_Pin_Spacer.stl
print_STL_cutter_v8/c8_Pinch_Yoke_CF.stl
print_STL_cutter_v8/single_plate/c8_ALL_PARTS_single_plate.stl
print_STL_cutter_v8/single_plate/c8_Pinch_Yoke_for_single_plate.stl
print_STL_cutter_v9/Strip_Cutter_v9_PETG-CF_0.6_nozzle.3mf
print_STL_cutter_v9/c9_Crank_keyed.stl
print_STL_cutter_v9/c9_Exit_Ramp.stl
print_STL_cutter_v9/c9_Front_Bracket.stl
print_STL_cutter_v9/c9_Main_Plate.stl
print_STL_cutter_v9/c9_Shaft_Keys_x8.stl
print_STL_feeder_v4/v4_Entry_Guide.stl
print_STL_feeder_v4/v4_Exit_Guide.stl
print_STL_feeder_v4/v4_Exit_Tie_Plate.stl
print_STL_feeder_v4/v4_Pinch_Yoke.stl
print_STL_feeder_v4/v4_Pivot_Bracket.stl
print_STL_feeder_v4/v4_Pivot_Sleeve.stl
print_STL_feeder_v5/v5_1_Exit_Guide.stl
print_STL_feeder_v5/v5_Exit_Guide.stl
print_STL_feeder_v6/Feeder_v6_exit_guide_long_nose_PETG-CF_0.6_nozzle.3mf
print_STL_feeder_v6/v6_Exit_Guide_long_nose.stl
print_STL_feeder_v6/v6_Exit_Guide_long_nose_assembly_position.stl
print_STL_hmi_enclosure_v1/HMI_enclosure_foot.stl
print_STL_hmi_enclosure_v1/HMI_enclosure_tower.stl
print_STL_hmi_panel_v1/HMI_front_plate_fitcheck.step
print_STL_hmi_panel_v1/HMI_front_plate_fitcheck.stl
print_STL_hmi_panel_v1/HMI_hole_gauge.step
print_STL_hmi_panel_v1/HMI_panel_fitcheck_A1.3mf
print_STL_hmi_panel_v1/HMI_panel_fitcheck_A1.gcode.3mf
print_STL_hmi_panel_v2/HMI_front_plate_v2.stl
