sri-automation/strip-cutter/electronics_v5_wiring.png

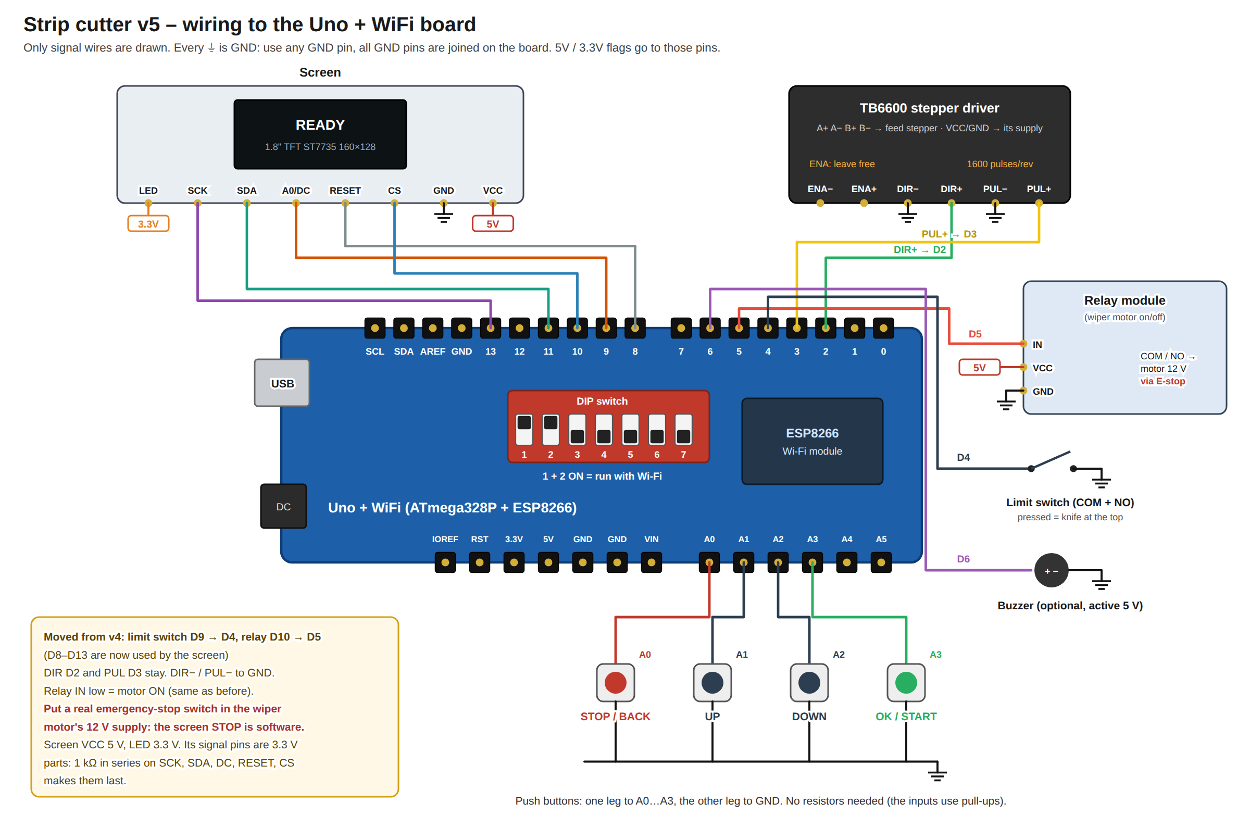
electronics_v5_wiring.png
