sri-automation/strip-cutter/print_STL_feeder_v7/v7_exit_guide_before_after.png

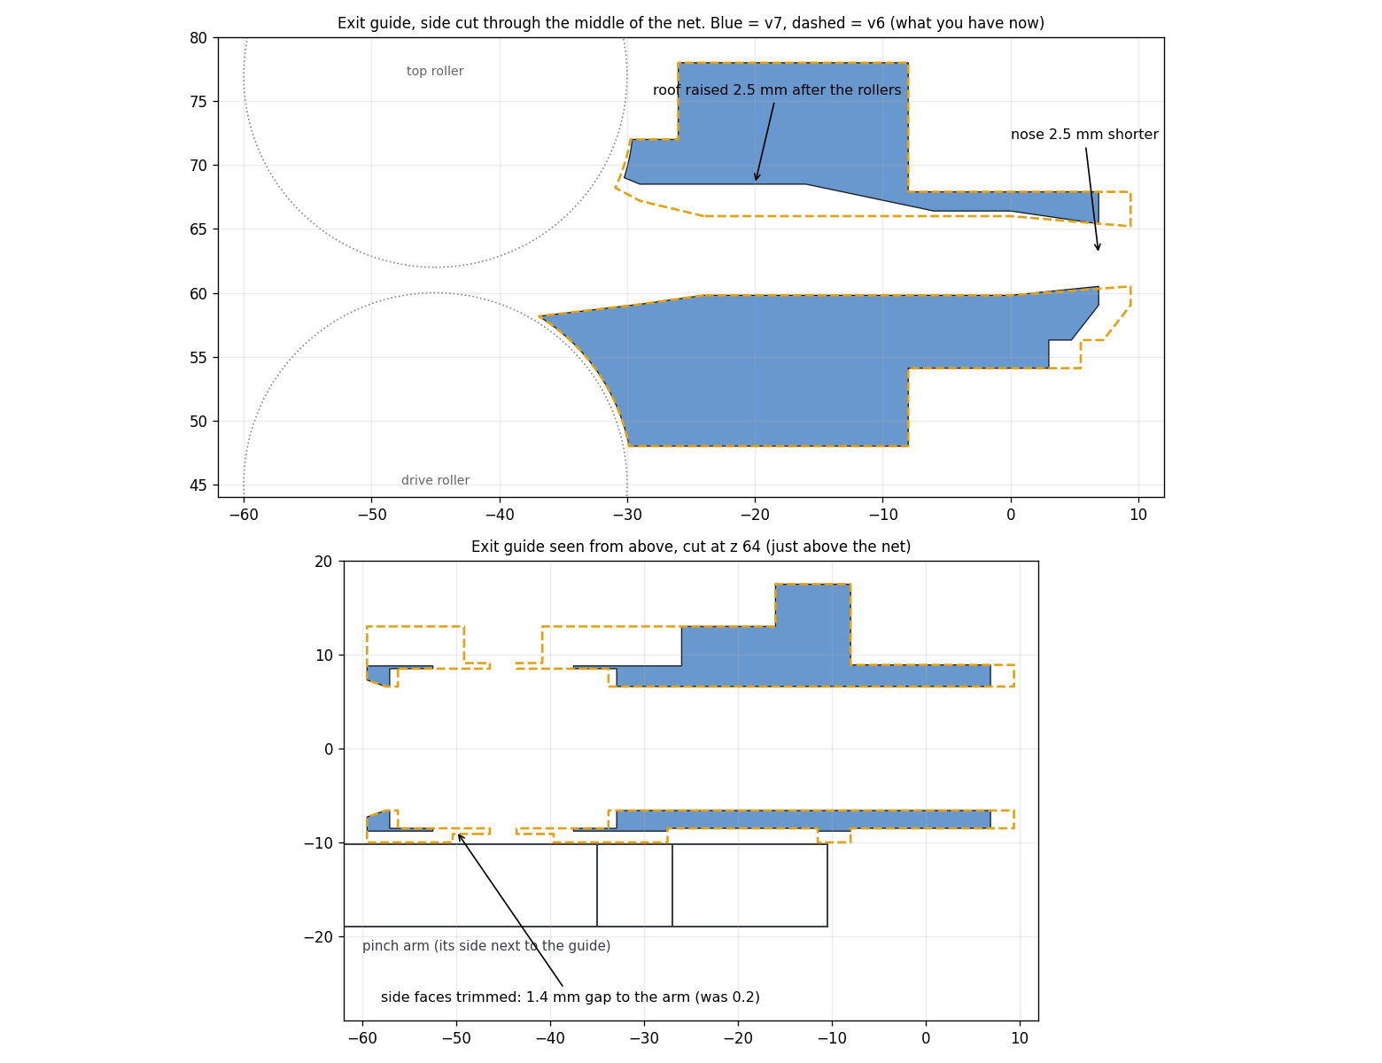
print_STL_feeder_v7/v7_exit_guide_before_after.png
