sri-automation/strip-cutter/print_STL_feeder_v7/v7_pinch_arm_before_after.png

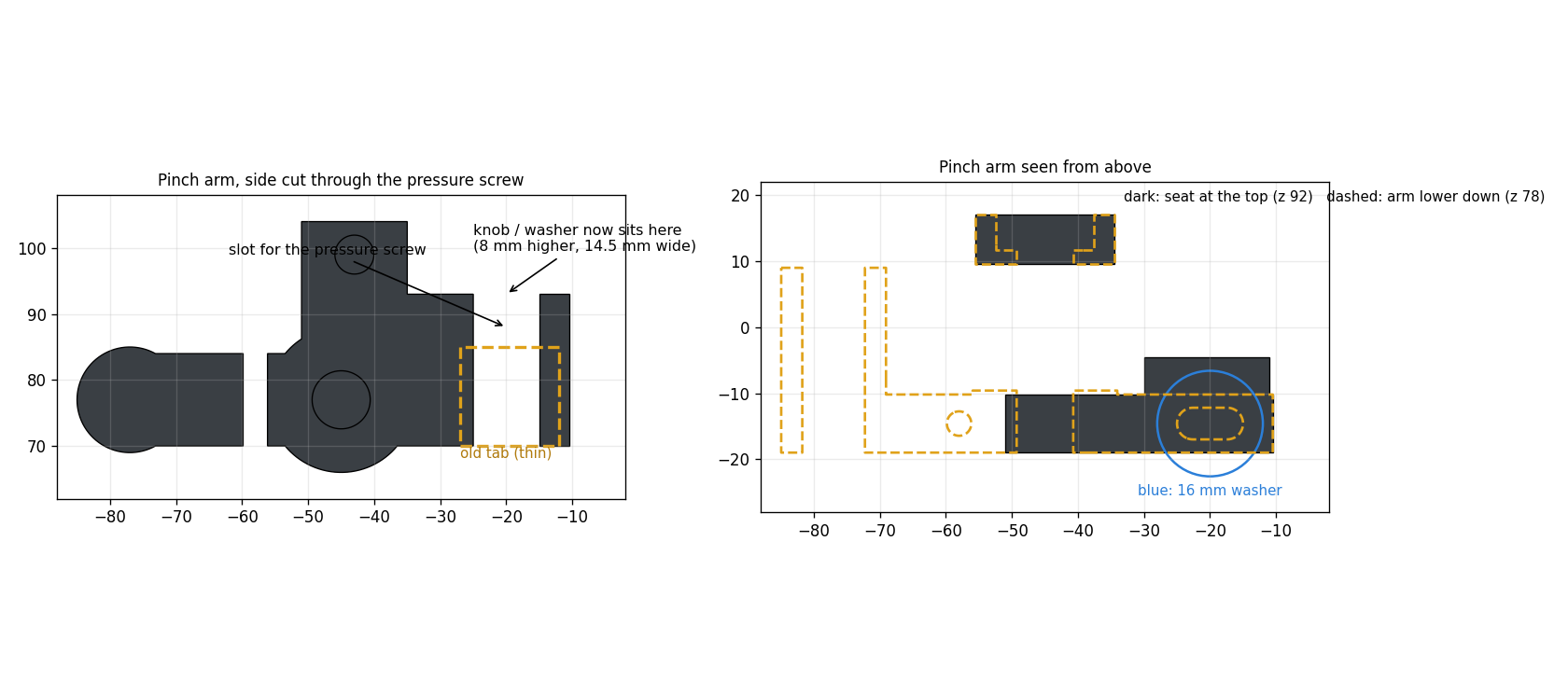
print_STL_feeder_v7/v7_pinch_arm_before_after.png
