sri-automation/strip-cutter/print_STL_hmi_panel_v2/HMI_front_plate_v2_preview.png

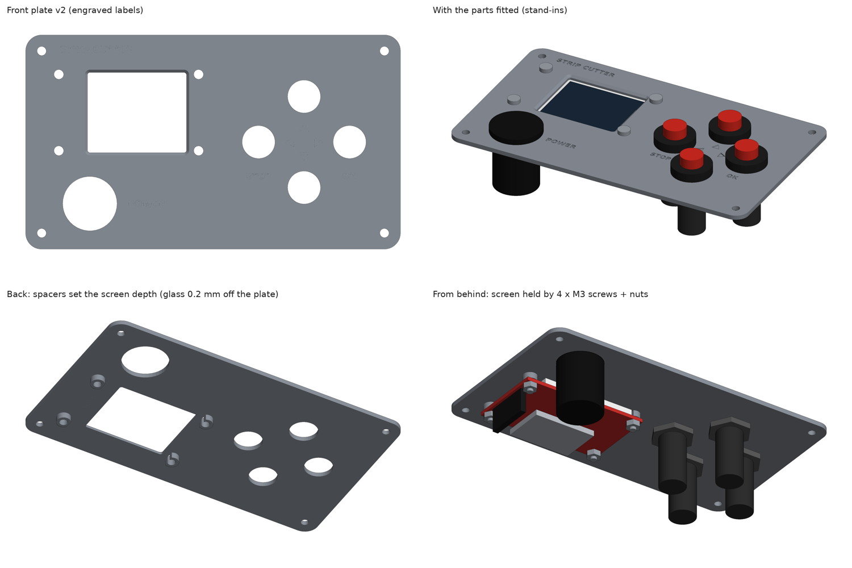
print_STL_hmi_panel_v2/HMI_front_plate_v2_preview.png
