sri-automation/strip-cutter/v5_exit_guide_iso.png

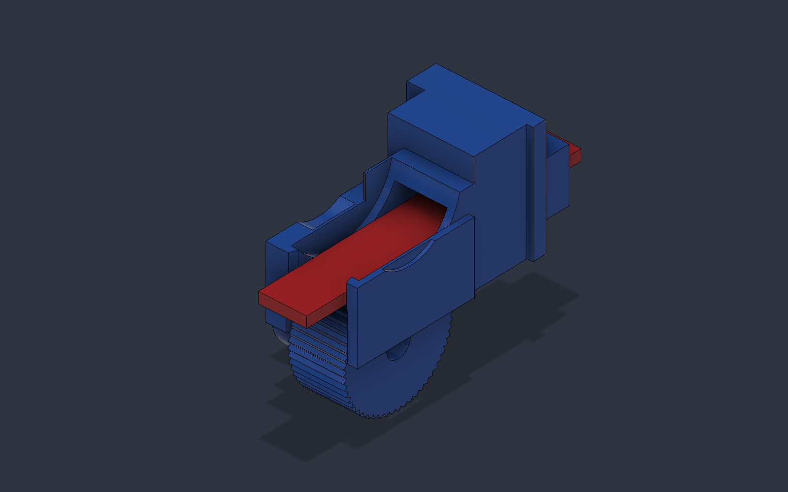
v5_exit_guide_iso.png
