sri-automation/strip-cutter/v5_exit_guide_top.png

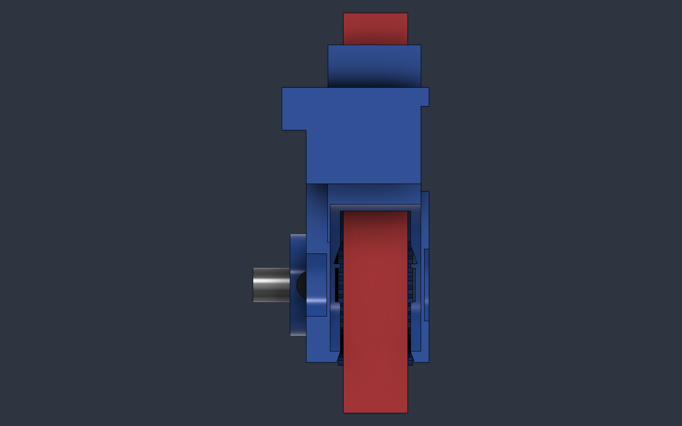
v5_exit_guide_top.png
