sri-automation/strip-cutter/v6_exit_guide_long_nose_side_view.png

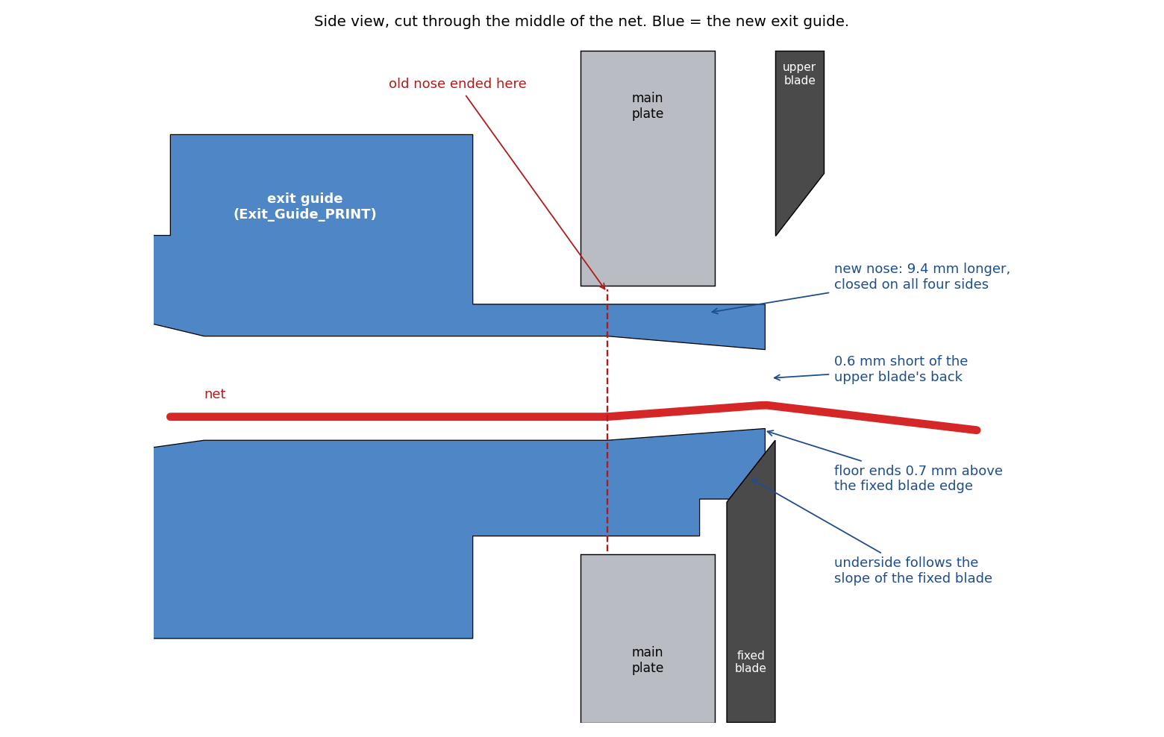
v6_exit_guide_long_nose_side_view.png
