sri-automation/strip-cutter/v6_wiring.png

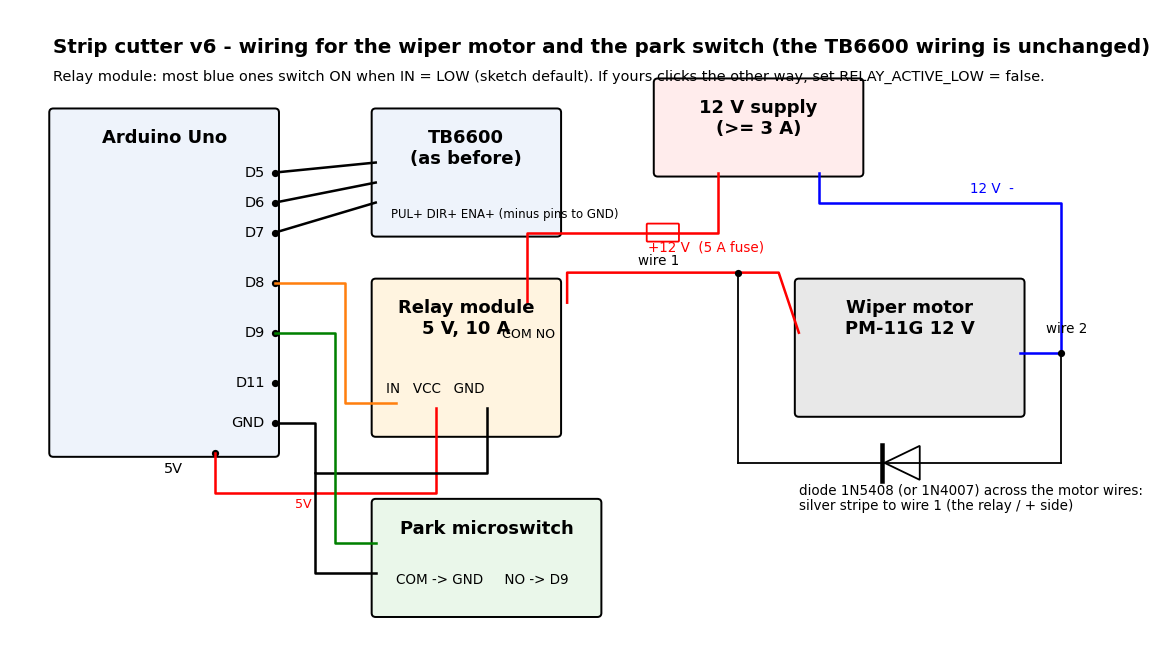
v6_wiring.png
