sri-automation/strip-cutter/v7_printed_cutter_back.png

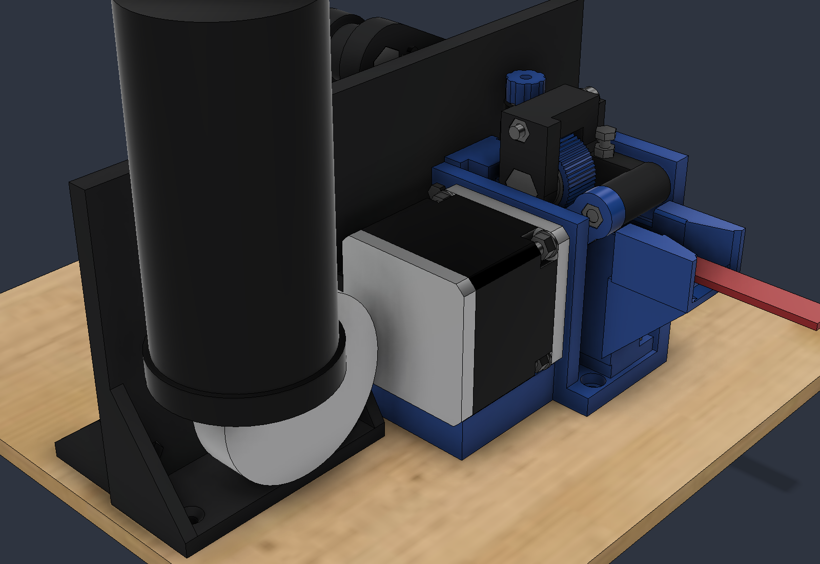
v7_printed_cutter_back.png
