sri-automation/strip-cutter/v7_printed_cutter_front.png

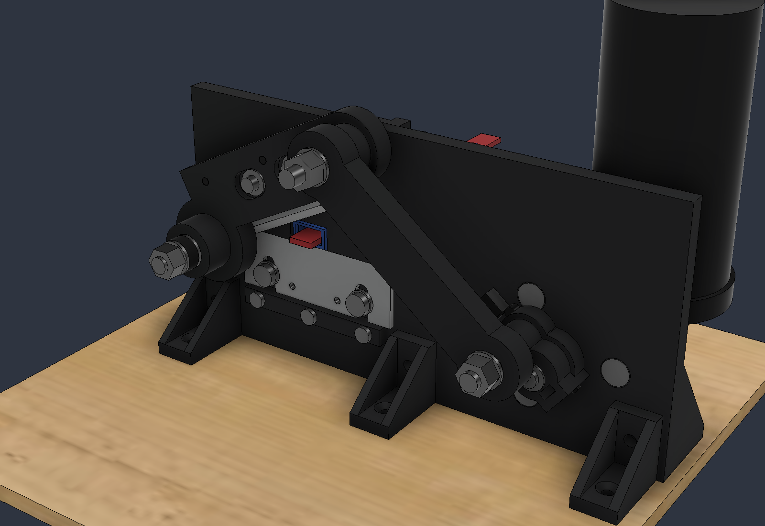
v7_printed_cutter_front.png
