sri-automation/strip-cutter/v8_printed_cutter_back.png

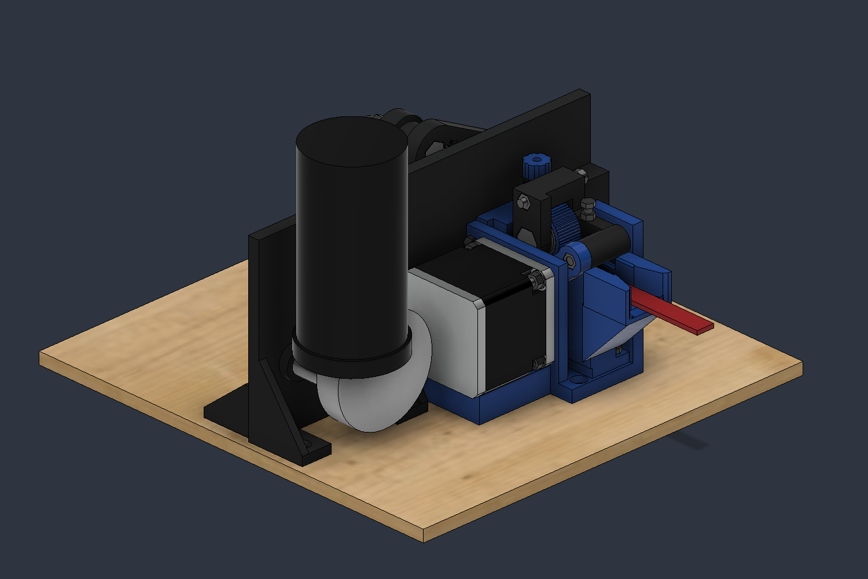
v8_printed_cutter_back.png
