sri-automation/strip-cutter/v8_printed_cutter_front.png

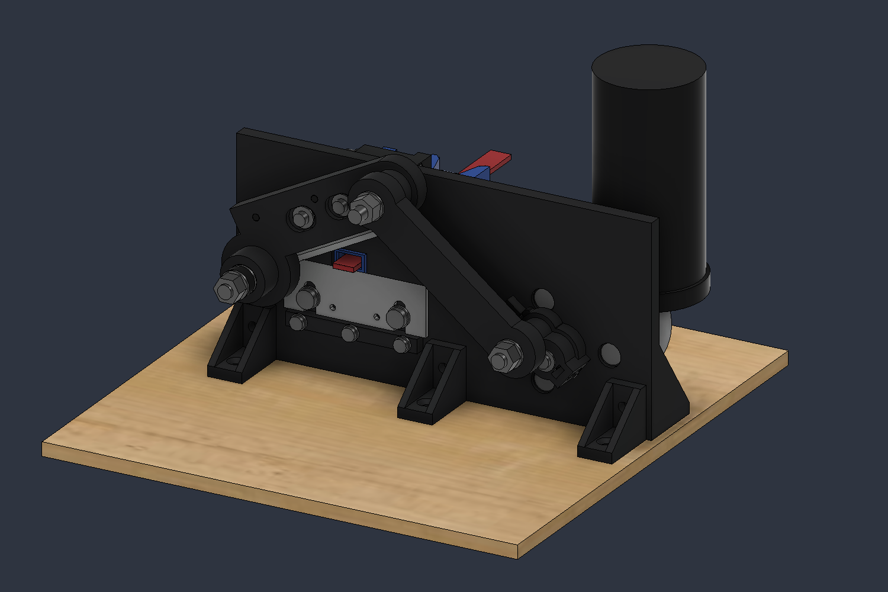
v8_printed_cutter_front.png
