sri-automation/strip-cutter/firmware/StripCutterWiFi/certs.h

// certs.h - root certificates used to check the cloud server (HiveMQ Cloud uses Let's Encrypt)
// ISRG Root X1 (valid to 2035) and ISRG Root X2 (valid to 2040), from letsencrypt.org/certs
#pragma once
// kept in flash; copied to RAM only while the cloud link starts
static const char ROOT_X1[] PROGMEM = R"PEM(
-----BEGIN CERTIFICATE-----
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
-----END CERTIFICATE-----
)PEM";
static const char ROOT_X2[] PROGMEM = R"PEM(
-----BEGIN CERTIFICATE-----
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
/q4AaOeMSQ+2b1tbFfLn
-----END CERTIFICATE-----
)PEM";
