sri-automation/strip-cutter/(commit log)

2026-10-26 Strip cutter project: firmware, app, print files, CAD and build notes
    - Machine sketch (FeedCutHMI, ATmega328P) and Wi-Fi sketch (StripCutterWiFi, ESP8266)
    - Control app; index.html is the same app, served by GitHub Pages
    - App: "Copy setup link" now always points at the online copy
    (https://sri-automation.github.io/strip-cutter/), also from the machine's page
    - tools/make_app_gz.py rebuilds index.html and app_gz.h from app/StripCutter.html
    - Print files (Bambu A1 projects, STL, STEP), Fusion/STEP CAD and build scripts
    - Build notes for feeder v3-v7, cutter v6-v11, electronics v5, HMI panel v1-v2
    Claude-Session: https://claude.ai/cod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
    [Drive_Roller_6.00mm_shaft.stl, Drive_Roller_6.35mm_shaft.stl, Entry_Guide.stl, Exit_Guide.stl, Feed_Frame.stl, Feeder_v6_exit_guide_long_nose_PETG-CF_0.6_nozzle.3mf, Feeder_v7_arm_and_exit_guide_PETG-CF_0.6_nozzle.3mf, HMI_front_plate_fitcheck.step]
2026-10-26 Wi-Fi details on the machine's screen; keep saved networks in crowded scans
    Wi-Fi module 1.1 (StripCutterWiFi):
    - remembers why each join ended (radio disconnect reason, wrong-password status,
    associated but no IP, timeout) and every saved network's signal and state
    - scans keep the saved networks first: with more than 24 access points around,
    the radio's list is not in signal order and a saved network could be dropped
    - answers $WD<page>[F] from the ATmega with framed rows "Y<row><colour><text>"
    (only changed rows), and $WJ = try the saved networks again now + rescan
    Machine sketch 5.1 (FeedCutHMI):
    - Wi-Fi & remote -> Wi-Fi details: 3 pages drawn from those rows
    (now / saved netwo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
    [FeedCutHMI.ino, StripCutterWiFi.ino, core.h, hmi.h]
2026-10-26 Wi-Fi module 1.2: join by name only, hotspot off on every second try
    - WiFi.begin(ssid, pass) without channel and BSSID: with a channel the core
    switches channel right after starting the connection, which can stall the
    join (most of all with the setup hotspot running). Roaming still names the BSSID.
    - every second join try is made with the setup hotspot off when no phone is on
    it and it was not opened by hand; it comes back at once if the try fails
    - radio country set to channels 1-13
    - details page: security and channel of each network in range ("WPA3?" =
    unusable by the ESP8266), raw facts of the last try (try number, reason code,
    Wi-Fi status, radio events, hotspot on), better h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
    [StripCutterWiFi.ino, core.h]
2026-10-27 WiFiTest: stand-alone ESP8266 join test with radio log, supply voltage and flash check
    Claude-Session: https://claude.ai/code/session_018ooASWtnrY7rRHngMq1Tyd
2026-10-27 Wi-Fi module 1.3: join exactly like the WiFiTest sketch that works on the board
    WiFiTest joined the user's network in 5.7 s on the same board, so the board,
    power and router are fine. Joins now copy that sequence:
    - the setup hotspot is off for every join try (back at once if it fails; if a
    phone was on it, it comes back for 3 minutes after a good join)
    - WiFi.disconnect() and 300 ms settle before WiFi.begin(name, password)
    - default modem sleep during the join, no-sleep only once connected
    - no manual radio country; join timeout 20 s
    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
    [StripCutterWiFi.ino, core.h]
2026-10-27 Wi-Fi module 1.4: let the radio retry while joining; local default network; Wi-Fi log
    - WiFi.setAutoReconnect(true), as the WiFiTest sketch that joins on this board:
    with it off, a join whose first attempt fails at a modest signal was given up
    by the radio without a word ("no answer from the router" on the screen)
    - wifi_local.h (not on GitHub, see wifi_local.example.h): a network the machine
    always knows, with its password, and WIFI_LOG
    - WIFI_LOG 1: join log plus the Wi-Fi library's messages on the serial port
    (read with DIP 5+6 and the Serial Monitor); lines start with "~" so the ATmega
    ignores them; the log stops once connected, after 10 minutes, and while the
    machine runs
    C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
    [StripCutterWiFi.ino, core.h, wifi_local.example.h]
2026-10-27 Wi-Fi module 1.5: fix the join timer - every join "timed out" at once since 1.0
    wifiTick() read "now" before handling a finished scan; the scan handler started
    the join and set wJoinStart = millis() later in the same call, so
    "now - wJoinStart" underflowed to ~4294967000 ms and the join was declared
    timed out and dropped immediately (log: "join FAILED after 4294966991 ms",
    0 radio events). The elapsed time is now read fresh, and the other
    unsigned time checks in wifiTick are signed.
    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
    [StripCutterWiFi.ino, core.h]
2026-10-27 HMI enclosure v1: 150 mm sloped stand (60 deg face) for the v2 front panel
    Tower + foot in PLA, wiring duct and exits, zip-tie anchors, sliced A1 plate
    (0.6 nozzle, 230 C, 5 walls, brim, no supports, 5 h 39 min, 236 g).
    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
    [HMI_enclosure_foot.step, HMI_enclosure_foot.stl, HMI_enclosure_tower.step, HMI_enclosure_tower.stl, HMI_enclosure_v1_A1.3mf, HMI_enclosure_v1_A1.gcode.3mf, HMI_enclosure_v1_assembly.step]
2026-10-30 Parking 5.2: wait before nudging, nudges from 1 ms, stop a nudge at the switch; parking settings in the app
    Machine sketch 5.2:
    - new settings P (wait after the switch-off before looking / nudging, 800 ms) and
    B (pause between nudges, 300 ms), on the screen (menu > Parking) and as commands
    - nudge E is now 1-100 ms; a nudge ends the moment the switch closes, and a nudge
    too short to move the knife gets a little longer every second try
    - distinct fault when the nudges never reach the switch; settings from 5.1 are kept
    - the old fixed 0.3 s settle let it nudge a knife that was still coasting, carry it
    past the switch and go round again until it gave up
    Wi-Fi module 1.6: carries the new a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
    [FeedCutHMI.ino, core.h, hmi.h]
2026-10-30 Machine 5.3: ride through an occasional slow cut instead of stopping; log slow turns
    - a turn more than 1.5x the usual is logged (run: slow turn X ms, usual Y) and the next
    feed is timed from the usual turn; stops on 3 slow turns in a row, a turn over 3x the
    first measured one, or no switch press within 2 turns after a feed (was half a turn)
    - parking after a run uses the usual turn, not a slow last one
    - shorter texts to make room (the machine sketch is at 99 % of flash)
    App: Run page counts slow turns and explains them. Wi-Fi module 1.7 carries the new app.
    Claude-Session: https://claude.ai/code/session_018ooASWtnrY7rRHngMq1Tyd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
    [FeedCutHMI.ino, core.h]
